sycomix/sumeru/sw/vhdl/timing_analysis_experiments/ram_propogation_test/TECHMAP.png

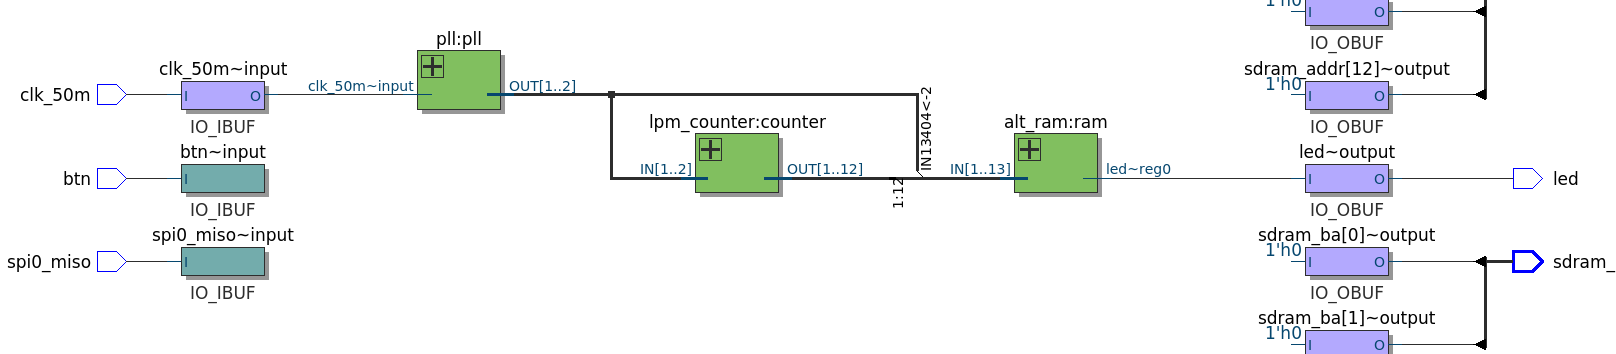
sw/vhdl/timing_analysis_experiments/ram_propogation_test/TECHMAP.png
