sycomix/sumeru/hw/pcb/mark1/mark1.kicad_pcb

## KiCad design hw/pcb/mark1/mark1.kicad_pcb (2019-08-19, an earlier design)

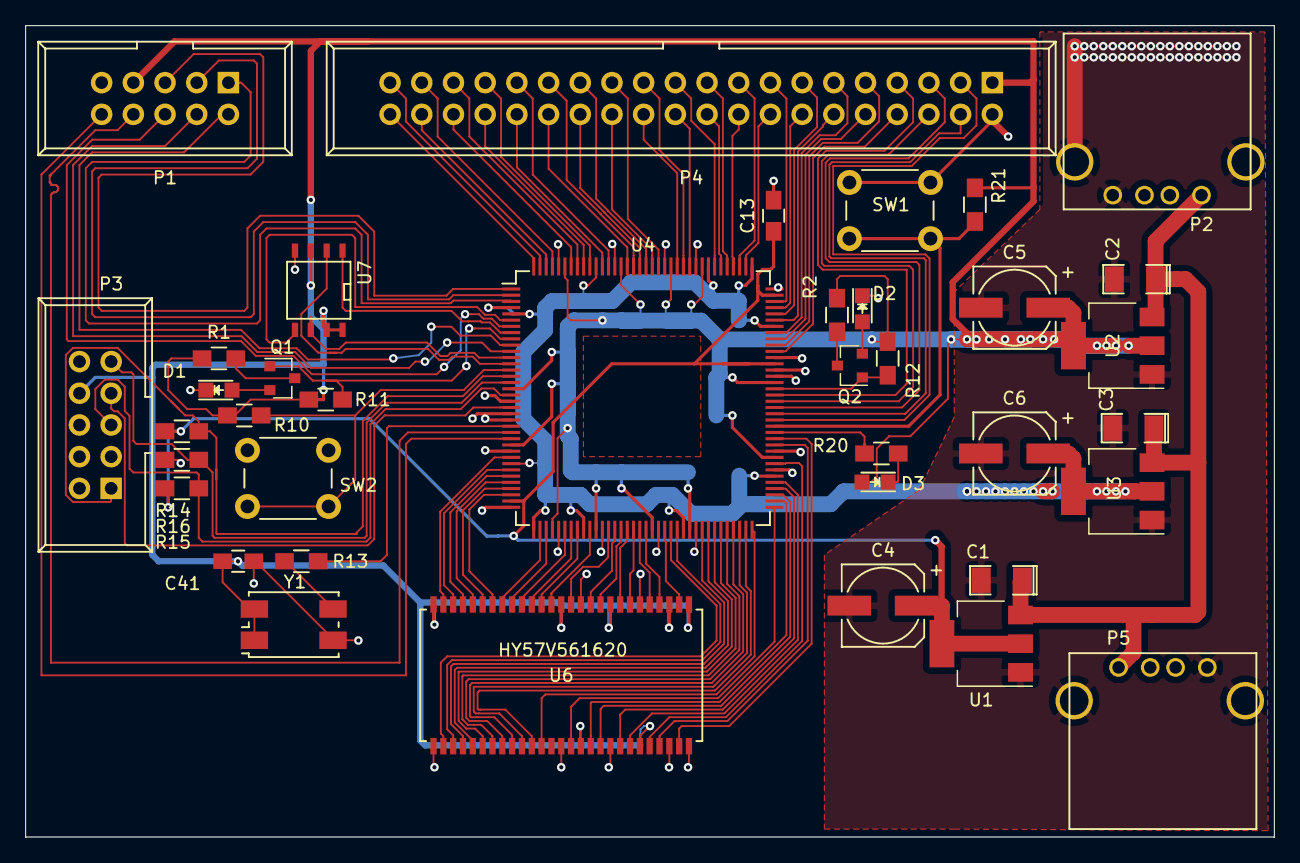
[picture p3: board mark1.kicad_pcb from above]

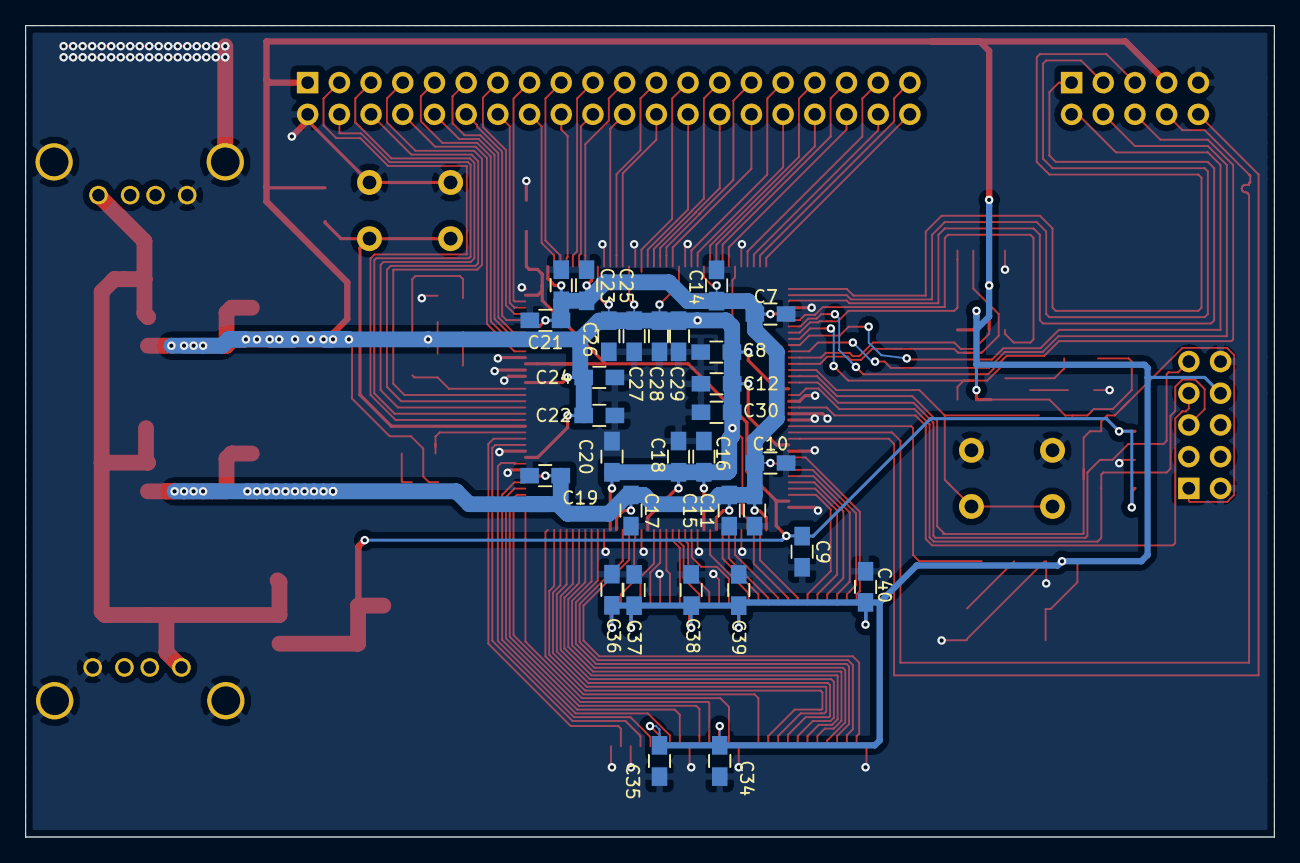
[picture p4: board mark1.kicad_pcb from below]

Board: 2 copper layers, 100.1 x 65.0 mm, 68 parts (30 on the bottom side), 110 nets.

Parts:
C1, C2, C3: 10uF; SMD-1206_Pol
C4, C5, C6: 100uF; c_elec_6.3x7.7
C7, C8, C9, C10, C11, C12, C13, C14, C15, C16, C17, C18, C19, C20, C21, C22, C23, C24, C25, C26, C27, C28, C29, C30, C34, C35, C36, C37, C38, C39, C40, C41: 100nF; C_0805_HandSoldering
D1, D2, D3: LED; LED_0805
P1, P3: CONN_02X05; IDC_Header_Straight_10pins
P2, P5: USB_A
P4: CONN_02X20; IDC_Header_Straight_40pins
Q1, Q2: MMBT3904; SOT-23
R1, R2, R16, R20: 1K; R_0805_HandSoldering
R10, R11, R12, R14, R15: 10K; R_0805_HandSoldering
R13: 33; R_0805_HandSoldering
R21: 1k; R_0805_HandSoldering
SW1, SW2: SW_Push; SW_PUSH_6mm_h4.3mm
U1: AMS1117-2.5; SOT-223
U2: AMS1117-3.3; SOT-223
U3: AMS1117-1.2; SOT-223
U4: EP4CE10E22C8N; TQFP-144_20x20mm_Pitch0.5mm
U6: HY57V561620; WIN_TSOP-54
U7: W25Q32FVSSIQ; SOIC-8-N
Y1: Crystal_GND23; Crystal_SMD_7050_4Pads_R

Connections:
/FPGA Configuration Circuitry/FLASH_MISO: U4.13, U7.2
/FPGA Configuration Circuitry/FLASH_MOSI: U4.6, U7.5
/FPGA Configuration Circuitry/FLASH_SCK: U4.12, U7.6
/FPGA Configuration Circuitry/FLASH_nCE: U4.8, U7.1
/FPGA Configuration Circuitry/F_CLK1: R13.2, U4.23
/FPGA Configuration Circuitry/JTAG_TCK: P3.9, R16.2, U4.16
/FPGA Configuration Circuitry/JTAG_TDI: P3.1, R14.2, U4.15
/FPGA Configuration Circuitry/JTAG_TDO: P3.7, U4.20
/FPGA Configuration Circuitry/JTAG_TMS: P3.5, R15.2, U4.18
/FPGA IO Circuitry/SDRAM1: U4.28, U6.26
/FPGA IO Circuitry/SDRAM2: U4.30, U6.25
/FPGA IO Circuitry/SDRAM3: U4.31, U6.24
/FPGA IO Circuitry/SDRAM4: U4.32, U6.23
/FPGA IO Circuitry/SDRAM5: U4.33, U6.22
/FPGA IO Circuitry/SDRAM6: U4.34, U6.21
/FPGA IO Circuitry/SDRAM7: U4.38, U6.20
/FPGA IO Circuitry/SDRAM8: U4.39, U6.19
/FPGA IO Circuitry/SDRAM9: U4.42, U6.18
/FPGA IO Circuitry/SDRAM10: U4.43, U6.17
/FPGA IO Circuitry/SDRAM11: U4.44, U6.16
/FPGA IO Circuitry/SDRAM12: U4.46, U6.15
/FPGA IO Circuitry/SDRAM13: U4.49, U6.13
/FPGA IO Circuitry/SDRAM14: U4.50, U6.11
/FPGA IO Circuitry/SDRAM15: U4.51, U6.10
/FPGA IO Circuitry/SDRAM16: U4.52, U6.8
/FPGA IO Circuitry/SDRAM17: U4.53, U6.7
/FPGA IO Circuitry/SDRAM18: U4.54, U6.5
/FPGA IO Circuitry/SDRAM19: U4.55, U6.4
/FPGA IO Circuitry/SDRAM20: U4.58, U6.2
/FPGA IO Circuitry/SDRAM21: U4.59, U6.29
/FPGA IO Circuitry/SDRAM22: U4.60, U6.30
/FPGA IO Circuitry/SDRAM23: U4.64, U6.31
/FPGA IO Circuitry/SDRAM24: U4.65, U6.32
/FPGA IO Circuitry/SDRAM25: U4.66, U6.33
/FPGA IO Circuitry/SDRAM26: U4.67, U6.34
/FPGA IO Circuitry/SDRAM27: U4.68, U6.35
/FPGA IO Circuitry/SDRAM28: U4.69, U6.36
/FPGA IO Circuitry/SDRAM29: U4.70, U6.37
/FPGA IO Circuitry/SDRAM30: U4.71, U6.38
/FPGA IO Circuitry/SDRAM31: U4.72, U6.39
/FPGA IO Circuitry/SDRAM32: U4.73, U6.42
/FPGA IO Circuitry/SDRAM33: U4.74, U6.44
/FPGA IO Circuitry/SDRAM34: U4.75, U6.45
/FPGA IO Circuitry/SDRAM35: U4.76, U6.47
/FPGA IO Circuitry/SDRAM36: U4.77, U6.48
/FPGA IO Circuitry/SDRAM37: U4.80, U6.50
/FPGA IO Circuitry/SDRAM38: U4.83, U6.51
/FPGA IO Circuitry/SDRAM39: U4.84, U6.53
F_CLK2: P1.8, U4.24
F_CLK3: P1.10, U4.25
F_CLK4: P4.7, U4.91
F_CLK5: P4.6, U4.90
F_CLK6: P4.5, U4.89
F_CLK7: P4.4, U4.88
GND: C1.2, C2.2, C3.2, C4.2, C5.2, C6.2, C7.2, C8.2, C9.2, C10.2, C11.2, C12.2, C13.2, C14.2, C15.2, C16.2, C17.2, C18.2, C19.2, C20.2, C21.2, C22.2, C23.2, C24.2, C25.2, C26.2, C27.2, C28.2, C29.2, C30.2, C34.2, C35.2, C36.2, C37.2, C38.2, C39.2, C40.2, C41.1, D1.1, D2.1, P1.9, P2.4, P2.5, P3.2, P3.10, P4.2, P5.4, P5.5, R16.1, SW1.1, SW2.1, U1.1, U2.1, U3.1, U4.4, U4.19, U4.21, U4.22, U4.27, U4.36, U4.41, U4.48, U4.57, U4.63, U4.79, U4.82, U4.94, U4.95, U4.97, U4.108, U4.118, U4.123, U4.131, U4.140, U6.6, U6.12, U6.28, U6.41, U6.46, U6.52, U6.54, U7.4, Y1.2
unnamed: D1.2, Q1.2
unnamed: D2.2, Q2.2
unnamed: D3.1, R20.2
unnamed: P1.1, U4.3
unnamed: P1.2, U4.10
unnamed: P1.3, U4.2
unnamed: P1.4, U4.11
unnamed: P1.5, U4.1
unnamed: P1.6, U4.7
unnamed: Q1.1, R11.1, U4.9
unnamed: Q1.3, R1.2
unnamed: Q2.1, R12.1, U4.92
unnamed: Q2.3, R2.2
unnamed: R10.1, SW2.2, U4.14
unnamed: R13.1, Y1.3
unnamed: R21.1, SW1.2, U4.86
PIN85: R20.1, U4.85
PIN87: P4.3, U4.87
PIN98: P4.8, U4.98
PIN99: P4.9, U4.99
PIN100: P4.10, U4.100
PIN101: P4.11, U4.101
PIN103: P4.12, U4.103
PIN104: P4.13, U4.104
PIN105: P4.14, U4.105
PIN106: P4.15, U4.106
PIN110: P4.16, U4.110
PIN111: P4.17, U4.111
PIN112: P4.18, U4.112
PIN113: P4.19, U4.113
PIN114: P4.20, U4.114
PIN115: P4.21, U4.115
PIN119: P4.22, U4.119
PIN120: P4.23, U4.120
PIN121: P4.24, U4.121
PIN124: P4.25, U4.124
PIN125: P4.26, U4.125
PIN126: P4.27, U4.126
PIN127: P4.28, U4.127
PIN128: P4.29, U4.128
PIN129: P4.30, U4.129
PIN132: P4.31, U4.132
PIN133: P4.32, U4.133
PIN135: P4.33, U4.135
PIN136: P4.34, U4.136
PIN137: P4.35, U4.137
PIN138: P4.36, U4.138
PIN141: P4.37, U4.141
PIN142: P4.38, U4.142
PIN143: P4.39, U4.143
PIN144: P4.40, U4.144
VCC: C1.1, C2.1, C3.1, P2.1, P5.1, U1.3, U2.3, U3.3
VCC1p2: C6.1, C7.1, C10.1, C11.1, C14.1, C15.1, C17.1, C19.1, C21.1, C23.1, C25.1, U3.2, U3.4, U4.5, U4.29, U4.37, U4.45, U4.61, U4.78, U4.102, U4.109, U4.116, U4.134
VCC2p5: C4.1, C9.1, C13.1, R14.1, R15.1, U1.2, U1.4, U4.35, U4.96, U4.107
VCC3p3: C5.1, C8.1, C12.1, C16.1, C18.1, C20.1, C22.1, C24.1, C26.1, C27.1, C28.1, C29.1, C30.1, C34.1, C35.1, C36.1, C37.1, C38.1, C39.1, C40.1, C41.2, D3.2, P1.7, P3.8, P4.1, R1.1, R2.1, R10.2, R11.2, R12.2, R21.2, U2.2, U2.4, U4.17, U4.26, U4.40, U4.47, U4.56, U4.62, U4.81, U4.93, U4.117, U4.122, U4.130, U4.139, U6.1, U6.3, U6.9, U6.14, U6.27, U6.43, U6.49, U7.3, U7.7, U7.8, Y1.1, Y1.4
