sycomix/sumeru/sw/kernels/newk/newk.c

#include <machine/constants.h>
#include <machine/csr.h>

#include <stdio.h>
#include <stdlib.h>

#include <machine/uart0.h>


int
main(int argc, char *argv)
{
    char buf[128];
    int c = 0;

    gpio_set_out(0);
    gpio_set_dir(1);
    uart0_start_engine();
    while (1) {
        fgets(buf, 128, stdin);
        fputs(buf, stdin);
    }
    return 0;
}
