sycomix/sumeru/sw/sys-libs/drivers/uart0.c

#include <machine/constants.h>
#include <machine/csr.h>
#include <machine/memctl.h>

#include <stdio.h>
#include <string.h>

#include <machine/uart0.h>

#define MIN(a,b)        (a <= b ? a : b)

consprod_t      g_uart0_tx_cp;
consprod_t      g_uart0_rx_cp;
volatile unsigned int g_uart0_flags = 0;
volatile unsigned int g_uart0_rx_lastpos = 0;
volatile unsigned int g_uart0_rx_timer_enable = 0;

void
uart0_start_engine()
{
    consprod_init(&g_uart0_tx_cp, 
                    (char *)UART0_TX_STREAMBUF_START, 
                    (char *)UART0_TX_STREAMBUF_END);

    consprod_init(&g_uart0_rx_cp, 
                    (char *)UART0_RX_STREAMBUF_START, 
                    (char *)UART0_RX_STREAMBUF_END);

    g_uart0_flags = UART0_ENGINE_ON;
    g_uart0_rx_lastpos = 0;
    uart0_set_rx(UART0_RX_DRVBUF_START | 255);
    timer_set(UART_ENGINE_TIMER_TICKS | 0xf);
}

void
uart0_stop_engine()
{
    g_uart0_flags = 0;
    uart0_set_rx(UART0_RX_DRVBUF_START);
}

int
uart0_blocking_write(const char *buf, unsigned int len)
{
    return consprod_produce(&g_uart0_tx_cp, buf, len, 1);
}

int
uart0_blocking_read(char *buf, unsigned int len)
{
    return consprod_consume(&g_uart0_rx_cp, buf, len, 1);
}


size_t
uart0_blocking_write_multiple(FILE *instance, const char *buf, size_t len)
{
    size_t w = 0;
    size_t count;

    while (w < len) {
        count = MIN(255, len - w);
        uart0_blocking_write(buf + w, count);
        w += count;
    }
    return w;
}

size_t
uart0_blocking_read_multiple(FILE *instance, char *buf, size_t len)
{
    size_t r = 0;
    size_t count;

    while (r < len) {
        count = MIN(255, len - r);
        uart0_blocking_read(buf + r, count);
        r += count;
    }
    return r;
}

struct File_methods uart0_fmethods = { 
    uart0_blocking_write_multiple, 
    uart0_blocking_read_multiple 
    };

struct File uart_fm = { &uart0_fmethods };

FILE* const stdin = &uart_fm;
FILE* const stdout = &uart_fm;
FILE* const stderr = &uart_fm;
