sycomix/sumeru/sw/vhdl/libsrc/rom_2048x16.vhd

LIBRARY ieee;
USE ieee.std_logic_1164.all;

LIBRARY altera_mf;
USE altera_mf.altera_mf_components.all;

ENTITY rom_2048x16 IS
        GENERIC
        (
                AWIDTH          : INTEGER := 11;
                DWIDTH          : INTEGER := 16;
                DATA_FILE       : STRING
        );
	PORT
	(
		address		: IN STD_LOGIC_VECTOR ((AWIDTH - 1) DOWNTO 0);
		clock		: IN STD_LOGIC  := '1';
		q		: OUT STD_LOGIC_VECTOR ((DWIDTH - 1) DOWNTO 0)
	);
END rom_2048x16;


ARCHITECTURE SYN OF rom_2048x16 IS

	SIGNAL sub_wire0	: STD_LOGIC_VECTOR (15 DOWNTO 0);

BEGIN
	q    <= sub_wire0(15 DOWNTO 0);

	altsyncram_component : altsyncram
	GENERIC MAP (
		address_aclr_a => "NONE",
		clock_enable_input_a => "BYPASS",
		clock_enable_output_a => "BYPASS",
		init_file => DATA_FILE,
		intended_device_family => "Cyclone IV E",
		lpm_hint => "ENABLE_RUNTIME_MOD=NO",
		lpm_type => "altsyncram",
		numwords_a => 2048,
		operation_mode => "ROM",
		outdata_aclr_a => "NONE",
		outdata_reg_a => "UNREGISTERED",
		ram_block_type => "M9K",
		widthad_a => AWIDTH,
		width_a => DWIDTH,
		width_byteena_a => 1
	)
	PORT MAP (
		address_a => address,
		clock0 => clock,
		q_a => sub_wire0
	);

END SYN;
