sycomix/sumeru/cpu/simulation/sim_sdram_mt48lc16m16a2.vhd

-- ******** TODO: Implement/Fix DQM logic to support 2 bytes instead of 1
--
LIBRARY IEEE;
    USE IEEE.STD_LOGIC_1164.ALL;
    USE IEEE.STD_LOGIC_UNSIGNED.ALL;
    USE IEEE.STD_LOGIC_ARITH.ALL;

ENTITY sim_sdram_mt48lc16m16a2 IS
    GENERIC (
        -- Timing Parameters for -75 (PC133) and CL = 3
        tAC       : TIME    :=  6 ns;
        tHZ       : TIME    :=  6 ns;
        tOH       : TIME    :=  3 ns;
        tMRD      : INTEGER :=  2;          -- 2 Clk Cycles
        tRAS      : TIME    := 44.0 ns;
        tRC       : TIME    := 66.0 ns;
        tRCD      : TIME    := 20.0 ns;
        tRFC      : TIME    := 66.0 ns;
        tRP       : TIME    := 20.0 ns;
        tRRD      : TIME    := 15.0 ns;
        tWRa      : TIME    :=  7.5 ns;     -- Auto precharge
        tWRm      : TIME    := 15.0 ns;     -- Manual Precharge

        tAH       : TIME    :=  0.8 ns;
        tAS       : TIME    :=  1.5 ns;
        tCH       : TIME    :=  2.5 ns;
        tCL       : TIME    :=  2.5 ns;
        tCK       : TIME    :=  7.5 ns;
        tDH       : TIME    :=  0.8 ns;
        tDS       : TIME    :=  1.5 ns;
        tCKH      : TIME    :=  0.8 ns;
        tCKS      : TIME    :=  1.5 ns;
        tCMH      : TIME    :=  0.8 ns;
        tCMS      : TIME    :=  1.5 ns;

        addr_bits : INTEGER := 13;
        data_bits : INTEGER := 16;
        col_bits  : INTEGER := 9
    );
    PORT (
        Dq    : INOUT STD_LOGIC_VECTOR (data_bits - 1 DOWNTO 0) := (OTHERS => 'Z');
        Addr  : IN    STD_LOGIC_VECTOR (addr_bits - 1 DOWNTO 0) := (OTHERS => '0');
        Ba    : IN    STD_LOGIC_VECTOR (1 DOWNTO 0) := "00";
        Clk   : IN    STD_LOGIC := '0';
        Cke   : IN    STD_LOGIC := '1';
        Cs_n  : IN    STD_LOGIC := '1';
        Ras_n : IN    STD_LOGIC := '1';
        Cas_n : IN    STD_LOGIC := '1';
        We_n  : IN    STD_LOGIC := '1';
        Dqm   : IN    STD_LOGIC_VECTOR(1 downto 0) := "00"
    );
END sim_sdram_mt48lc16m16a2;

ARCHITECTURE behave OF sim_sdram_mt48lc16m16a2 IS
    TYPE   State       IS (BST, NOP, PRECH, READ, WRITE);
    TYPE   Array4xI    IS ARRAY (3 DOWNTO 0) OF INTEGER;
    TYPE   Array4xT    IS ARRAY (3 DOWNTO 0) OF TIME;
    TYPE   Array4xB    IS ARRAY (3 DOWNTO 0) OF STD_LOGIC;
    TYPE   Array4x2BV  IS ARRAY (3 DOWNTO 0) OF STD_LOGIC_VECTOR (1 DOWNTO 0);
    TYPE   Array4xCBV  IS ARRAY (4 DOWNTO 0) OF STD_LOGIC_VECTOR (Col_bits - 1 DOWNTO 0);
    TYPE   Array_state IS ARRAY (4 DOWNTO 0) OF State;
    SIGNAL Mode_reg : STD_LOGIC_VECTOR (addr_bits - 1 DOWNTO 0) := (OTHERS => '0');
    SIGNAL Active_enable, Aref_enable, Burst_term : STD_LOGIC := '0';
    SIGNAL Mode_reg_enable, Prech_enable, Read_enable, Write_enable : STD_LOGIC := '0';
    SIGNAL Burst_length_1, Burst_length_2, Burst_length_4, Burst_length_8 : STD_LOGIC := '0';
    SIGNAL Cas_latency_2, Cas_latency_3 : STD_LOGIC := '0';
    SIGNAL Cs_in, Ras_in, Cas_in, We_in : STD_LOGIC := '0';
    SIGNAL Write_burst_mode : STD_LOGIC := '0';
    SIGNAL Sys_clk, CkeZ : STD_LOGIC := '0';

    type commands is (INH, NOP, ACT, RD, WR, BT, PRE, REF, MD, XX);
    signal command : commands;
    signal cmdbits : std_logic_vector(3 downto 0);


BEGIN
    cmdbits <= Cs_n & Ras_n & Cas_n & We_n;
    command <=
      INH when cmdbits = "1111" else
      NOP when cmdbits = "0111" else
      ACT when cmdbits = "0011" else
      RD when cmdbits = "0101" else
      WR when cmdbits = "0100" else
      BT when cmdbits = "0110" else
      PRE when cmdbits = "0010" else
      REF when cmdbits = "0001" else
      MD when cmdbits = "0000" else
      XX;

    -- Strip the strength
    Cs_in  <= To_X01 (Cs_n);
    Ras_in <= To_X01 (Ras_n);
    Cas_in <= To_X01 (Cas_n);
    We_in  <= To_X01 (We_n);
    
    -- Commands Decode
    Active_enable   <= NOT(Cs_in) AND NOT(Ras_in) AND     Cas_in  AND     We_in;
    Aref_enable     <= NOT(Cs_in) AND NOT(Ras_in) AND NOT(Cas_in) AND     We_in;
    Burst_term      <= NOT(Cs_in) AND     Ras_in  AND     Cas_in  AND NOT(We_in);
    Mode_reg_enable <= NOT(Cs_in) AND NOT(Ras_in) AND NOT(Cas_in) AND NOT(We_in);
    Prech_enable    <= NOT(Cs_in) AND NOT(Ras_in) AND     Cas_in  AND NOT(We_in);
    Read_enable     <= NOT(Cs_in) AND     Ras_in  AND NOT(Cas_in) AND     We_in;
    Write_enable    <= NOT(Cs_in) AND     Ras_in  AND NOT(Cas_in) AND NOT(We_in);

    -- Burst Length Decode
    Burst_length_1  <= NOT(Mode_reg(2)) AND NOT(Mode_reg(1)) AND NOT(Mode_reg(0));
    Burst_length_2  <= NOT(Mode_reg(2)) AND NOT(Mode_reg(1)) AND     Mode_reg(0);
    Burst_length_4  <= NOT(Mode_reg(2)) AND     Mode_reg(1)  AND NOT(Mode_reg(0));
    Burst_length_8  <= NOT(Mode_reg(2)) AND     Mode_reg(1)  AND     Mode_reg(0);

    -- CAS Latency Decode
    Cas_latency_2   <= NOT(Mode_reg(6)) AND     Mode_reg(5)  AND NOT(Mode_reg(4));
    Cas_latency_3   <= NOT(Mode_reg(6)) AND     Mode_reg(5)  AND     Mode_reg(4);

    -- Write Burst Mode
    Write_burst_mode <= Mode_reg(9);

    -- System Clock
    int_clk : PROCESS (Clk)
    BEGIN
        IF Clk'LAST_VALUE = '0' AND Clk = '1' THEN
            CkeZ <= Cke;
        END IF;
        Sys_clk <= CkeZ AND Clk;
    END PROCESS;

    state_register : PROCESS
        TYPE ram_type IS ARRAY (2**col_bits - 1 DOWNTO 0) OF STD_LOGIC_VECTOR ((data_bits / 2) - 1 DOWNTO 0);
        TYPE ram_pntr IS ACCESS ram_type;
        TYPE ram_stor IS ARRAY (2**addr_bits - 1 DOWNTO 0) OF ram_pntr;
        VARIABLE Bank0_a : ram_stor;
        VARIABLE Bank0_b : ram_stor;
        VARIABLE Bank1_a : ram_stor;
        VARIABLE Bank1_b : ram_stor;
        VARIABLE Bank2_a : ram_stor;
        VARIABLE Bank2_b : ram_stor;
        VARIABLE Bank3_a : ram_stor;
        VARIABLE Bank3_b : ram_stor;
        VARIABLE Row_index, Col_index : INTEGER := 0;
        VARIABLE Dq_temp_a : STD_LOGIC_VECTOR ((data_bits / 2) - 1 DOWNTO 0) := (OTHERS => '0');
        VARIABLE Dq_temp_b : STD_LOGIC_VECTOR ((data_bits / 2) - 1 DOWNTO 0) := (OTHERS => '0');

        VARIABLE Col_addr : Array4xCBV;
        VARIABLE Bank_addr : Array4x2BV;
        VARIABLE Dqm_reg0, Dqm_reg1 : STD_LOGIC_VECTOR(1 downto 0) := "11";

        VARIABLE Bank, Prev_bank : STD_LOGIC_VECTOR (1 DOWNTO 0) := "00";
        VARIABLE B0_row_addr, B1_row_addr, B2_row_addr, B3_row_addr : STD_LOGIC_VECTOR (addr_bits - 1 DOWNTO 0) := (OTHERS => '0');
        VARIABLE Col_brst : STD_LOGIC_VECTOR (col_bits - 1 DOWNTO 0) := (OTHERS => '0');
        VARIABLE Row : STD_LOGIC_VECTOR (addr_bits - 1 DOWNTO 0) := (OTHERS => '0');
        VARIABLE Col : STD_LOGIC_VECTOR (col_bits - 1 DOWNTO 0) := (OTHERS => '0');
        VARIABLE Burst_counter : INTEGER := 0;

        VARIABLE Command : Array_state;
        VARIABLE Bank_precharge : Array4x2BV;
        VARIABLE A10_precharge : Array4xB := ('0' & '0' & '0' & '0');
        VARIABLE Auto_precharge : Array4xB := ('0' & '0' & '0' & '0');
        VARIABLE Read_precharge : Array4xB := ('0' & '0' & '0' & '0');
        VARIABLE Write_precharge : Array4xB := ('0' & '0' & '0' & '0');
        VARIABLE RW_interrupt_read : Array4xB := ('0' & '0' & '0' & '0');
        VARIABLE RW_interrupt_write : Array4xB := ('0' & '0' & '0' & '0');
        VARIABLE RW_interrupt_bank : STD_LOGIC_VECTOR (1 DOWNTO 0) := "00";
        VARIABLE RW_interrupt_counter : Array4xI := (0 & 0 & 0 & 0);
        VARIABLE Count_precharge : Array4xI := (0 & 0 & 0 & 0);

        VARIABLE Data_in_enable, Data_out_enable : STD_LOGIC := '0';
        VARIABLE Pc_b0, Pc_b1, Pc_b2, Pc_b3 : STD_LOGIC := '0';
        VARIABLE Act_b0, Act_b1, Act_b2, Act_b3 : STD_LOGIC := '1';

        -- Timing Check
        VARIABLE MRD_chk : INTEGER := 0;
        VARIABLE RFC_chk : TIME := 0 ns;
        VARIABLE RRD_chk : TIME := 0 ns;
        VARIABLE WR_chkm : Array4xT := (0 ns & 0 ns & 0 ns & 0 ns);
        VARIABLE RAS_chk0, RAS_chk1, RAS_chk2, RAS_chk3 : TIME := 0 ns;
        VARIABLE RC_chk0, RC_chk1, RC_chk2, RC_chk3 : TIME := 0 ns;
        VARIABLE RCD_chk0, RCD_chk1, RCD_chk2, RCD_chk3 : TIME := 0 ns;
        VARIABLE RP_chk0, RP_chk1, RP_chk2, RP_chk3 : TIME := 0 ns;

        -- Initialize empty rows
        PROCEDURE Init_mem_a (Bank : STD_LOGIC_VECTOR (1 DOWNTO 0); Row_index : INTEGER) IS
            VARIABLE i, j : INTEGER := 0;
        BEGIN
            IF Bank = "00" THEN
                IF Bank0_a (Row_index) = NULL THEN                      -- Check to see if row empty
                    Bank0_a (Row_index) := NEW ram_type;                  -- Open new row for access
                    FOR i IN (2**col_bits - 1) DOWNTO 0 LOOP            -- Filled row with zeros
                        FOR j IN ((data_bits / 2) - 1) DOWNTO 0 LOOP
                            Bank0_a (Row_index) (i) (j) := '0';
                        END LOOP;
                    END LOOP;
                END IF;
            ELSIF Bank = "01" THEN
                IF Bank1_a (Row_index) = NULL THEN
                    Bank1_a (Row_index) := NEW ram_type;
                    FOR i IN (2**col_bits - 1) DOWNTO 0 LOOP
                        FOR j IN ((data_bits / 2) - 1) DOWNTO 0 LOOP
                            Bank1_a (Row_index) (i) (j) := '0';
                        END LOOP;
                    END LOOP;
                END IF;
            ELSIF Bank = "10" THEN
                IF Bank2_a (Row_index) = NULL THEN
                    Bank2_a (Row_index) := NEW ram_type;
                    FOR i IN (2**col_bits - 1) DOWNTO 0 LOOP
                        FOR j IN ((data_bits / 2) - 1) DOWNTO 0 LOOP
                            Bank2_a (Row_index) (i) (j) := '0';
                        END LOOP;
                    END LOOP;
                END IF;
            ELSIF Bank = "11" THEN
                IF Bank3_a (Row_index) = NULL THEN
                    Bank3_a (Row_index) := NEW ram_type;
                    FOR i IN (2**col_bits - 1) DOWNTO 0 LOOP
                        FOR j IN ((data_bits / 2) - 1) DOWNTO 0 LOOP
                            Bank3_a (Row_index) (i) (j) := '0';
                        END LOOP;
                    END LOOP;
                END IF;
            END IF;
        END;

        PROCEDURE Init_mem_b (Bank : STD_LOGIC_VECTOR (1 DOWNTO 0); Row_index : INTEGER) IS
            VARIABLE i, j : INTEGER := 0;
        BEGIN
            IF Bank = "00" THEN
                IF Bank0_b (Row_index) = NULL THEN                      -- Check to see if row empty
                    Bank0_b (Row_index) := NEW ram_type;                  -- Open new row for access
                    FOR i IN (2**col_bits - 1) DOWNTO 0 LOOP            -- Filled row with zeros
                        FOR j IN ((data_bits / 2) - 1) DOWNTO 0 LOOP
                            Bank0_b (Row_index) (i) (j) := '0';
                        END LOOP;
                    END LOOP;
                END IF;
            ELSIF Bank = "01" THEN
                IF Bank1_b (Row_index) = NULL THEN
                    Bank1_b (Row_index) := NEW ram_type;
                    FOR i IN (2**col_bits - 1) DOWNTO 0 LOOP
                        FOR j IN ((data_bits / 2) - 1) DOWNTO 0 LOOP
                            Bank1_b (Row_index) (i) (j) := '0';
                        END LOOP;
                    END LOOP;
                END IF;
            ELSIF Bank = "10" THEN
                IF Bank2_b (Row_index) = NULL THEN
                    Bank2_b (Row_index) := NEW ram_type;
                    FOR i IN (2**col_bits - 1) DOWNTO 0 LOOP
                        FOR j IN ((data_bits / 2) - 1) DOWNTO 0 LOOP
                            Bank2_b (Row_index) (i) (j) := '0';
                        END LOOP;
                    END LOOP;
                END IF;
            ELSIF Bank = "11" THEN
                IF Bank3_b (Row_index) = NULL THEN
                    Bank3_b (Row_index) := NEW ram_type;
                    FOR i IN (2**col_bits - 1) DOWNTO 0 LOOP
                        FOR j IN ((data_bits / 2) - 1) DOWNTO 0 LOOP
                            Bank3_b (Row_index) (i) (j) := '0';
                        END LOOP;
                    END LOOP;
                END IF;
            END IF;
        END;

        -- Burst Counter
        PROCEDURE Burst_decode IS
            VARIABLE Col_int : INTEGER := 0;
            VARIABLE Col_vec, Col_temp : STD_LOGIC_VECTOR (col_bits - 1 DOWNTO 0) := (OTHERS => '0');
        BEGIN
            -- Advance Burst Counter
            Burst_counter := Burst_counter + 1;

            -- Burst Type
            IF Mode_reg (3) = '0' THEN
                Col_int := conv_integer(Col) + 1;
                Col_temp := CONV_STD_LOGIC_VECTOR(Col_int, col_bits);
            ELSIF Mode_reg (3) = '1' THEN
                Col_vec := CONV_STD_LOGIC_VECTOR(Burst_counter, col_bits);
                Col_temp (2) := Col_vec (2) XOR Col_brst (2);
                Col_temp (1) := Col_vec (1) XOR Col_brst (1);
                Col_temp (0) := Col_vec (0) XOR Col_brst (0);
            END IF;

            -- Burst Length
            IF Burst_length_2 = '1' THEN
                Col (0) := Col_temp (0);
            ELSIF Burst_length_4 = '1' THEN
                Col (1 DOWNTO 0) := Col_temp (1 DOWNTO 0);
            ELSIF Burst_length_8 = '1' THEN
                Col (2 DOWNTO 0) := Col_temp (2 DOWNTO 0);
            ELSE
                Col := Col_temp;
            END IF;

            -- Burst Read Single Write
            IF Write_burst_mode = '1' AND Data_in_enable = '1' THEN
                Data_in_enable := '0';
            END IF;

            -- Data counter
            IF Burst_length_1 = '1' THEN
                IF Burst_counter >= 1 THEN
                    IF Data_in_enable = '1' THEN
                        Data_in_enable := '0';
                    ELSIF Data_out_enable = '1' THEN
                        Data_out_enable := '0';
                    END IF;
                END IF;
            ELSIF Burst_length_2 = '1' THEN
                IF Burst_counter >= 2 THEN
                    IF Data_in_enable = '1' THEN
                        Data_in_enable := '0';
                    ELSIF Data_out_enable = '1' THEN
                        Data_out_enable := '0';
                    END IF;
                END IF;
            ELSIF Burst_length_4 = '1' THEN
                IF Burst_counter >= 4 THEN
                    IF Data_in_enable = '1' THEN
                        Data_in_enable := '0';
                    ELSIF Data_out_enable = '1' THEN
                        Data_out_enable := '0';
                    END IF;
                END IF;
            ELSIF Burst_length_8 = '1' THEN
                IF Burst_counter >= 8 THEN
                    IF Data_in_enable = '1' THEN
                        Data_in_enable := '0';
                    ELSIF Data_out_enable = '1' THEN
                        Data_out_enable := '0';
                    END IF;
                END IF;
            END IF;
        END;

    BEGIN
        WAIT ON Sys_clk;
        IF Sys_clk'event AND Sys_clk = '1' THEN
            -- Internal Pipeline
            Command(0) := Command(1);
            Command(1) := Command(2);
            Command(2) := Command(3);
            Command(3) := NOP;

            Col_addr(0) := Col_addr(1);
            Col_addr(1) := Col_addr(2);
            Col_addr(2) := Col_addr(3);
            Col_addr(3) := (OTHERS => '0');
            
            Bank_addr(0) := Bank_addr(1);
            Bank_addr(1) := Bank_addr(2);
            Bank_addr(2) := Bank_addr(3);
            Bank_addr(3) := "00";

            Bank_precharge(0) := Bank_precharge(1);
            Bank_precharge(1) := Bank_precharge(2);
            Bank_precharge(2) := Bank_precharge(3);
            Bank_precharge(3) := "00";

            A10_precharge(0) := A10_precharge(1);
            A10_precharge(1) := A10_precharge(2);
            A10_precharge(2) := A10_precharge(3);
            A10_precharge(3) := '0';
            
            -- Dqm pipeline for Read
            Dqm_reg0 := Dqm_reg1;
            Dqm_reg1 := Dqm;

            -- Read or Write with Auto Precharge Counter
            IF Auto_precharge (0) = '1' THEN
                Count_precharge (0) := Count_precharge (0) + 1;
            END IF;
            IF Auto_precharge (1) = '1' THEN
                Count_precharge (1) := Count_precharge (1) + 1;
            END IF;
            IF Auto_precharge (2) = '1' THEN
                Count_precharge (2) := Count_precharge (2) + 1;
            END IF;
            IF Auto_precharge (3) = '1' THEN
                Count_precharge (3) := Count_precharge (3) + 1;
            END IF;

            -- Read or Write Interrupt Counter
            IF RW_interrupt_write (0) = '1' THEN
               RW_interrupt_counter  (0) := RW_interrupt_counter (0) + 1;
            END IF;
            IF RW_interrupt_write (1) = '1' THEN
                RW_interrupt_counter (1) := RW_interrupt_counter (1) + 1;
            END IF;
            IF RW_interrupt_write (2) = '1' THEN
                RW_interrupt_counter (2) := RW_interrupt_counter (2) + 1;
            END IF;
            IF RW_interrupt_write (3) = '1' THEN
                RW_interrupt_counter (3) := RW_interrupt_counter (3) + 1;
            END IF;

            -- tMRD Counter
            MRD_chk := MRD_chk + 1;

            -- Auto Refresh
            IF Aref_enable = '1' THEN
                -- Auto Refresh to Auto Refresh
                ASSERT (NOW - RFC_chk >= tRFC)
                    REPORT "tRFC violation during Auto Refresh"
                    SEVERITY WARNING;

                -- Precharge to Auto Refresh
                ASSERT ((NOW - RP_chk0 >= tRP) OR (NOW - RP_chk1 >= tRP) OR 
                        (NOW - RP_chk2 >= tRP) OR (NOW - RP_chk3 >= tRP))
                    REPORT "tRP violation during Auto Refresh"
                    SEVERITY WARNING;

                -- Precharge to Auto Refresh
                ASSERT (Pc_b0 ='1' AND Pc_b1 = '1' AND Pc_b2 ='1' AND Pc_b3 = '1')
                    REPORT "All banks must be Precharge before Auto Refresh"
                    SEVERITY WARNING;

                -- Load Mode Register to Auto Refresh
                ASSERT (MRD_chk >= tMRD)
                    REPORT "tMRD violation during Auto Refresh"
                    SEVERITY WARNING;

                -- Record current tRFC time
                RFC_chk := NOW;
            END IF;

            -- Load Mode Register
            IF Mode_reg_enable = '1' THEN
                -- Register Mode
                Mode_reg <= Addr;

                -- Precharge to Load Mode Register
                ASSERT (Pc_b0 ='1' AND Pc_b1 = '1' AND Pc_b2 ='1' AND Pc_b3 = '1')
                    REPORT "All banks must be Precharge before Load Mode Register"
                    SEVERITY WARNING;

                -- Precharge to Load Mode Register
                ASSERT ((NOW - RP_chk0 >= tRP) OR (NOW - RP_chk1 >= tRP) OR 
                        (NOW - RP_chk2 >= tRP) OR (NOW - RP_chk3 >= tRP))
                    REPORT "tRP violation during Load Mode Register"
                    SEVERITY WARNING;

                -- Auto Refresh to Load Mode Register
                ASSERT (NOW - RFC_chk >= tRFC)
                    REPORT "tRFC violation during Load Mode Register"
                    SEVERITY WARNING;

                -- Load Mode Register to Load Mode Register
                ASSERT (MRD_chk >= tMRD)
                    REPORT "tMRD violation during Load Mode Register"
                    SEVERITY WARNING;

                -- Record current tMRD time
                MRD_chk := 0;
            END IF;

            -- Active Block (Latch Bank and Row Address)
            IF Active_enable = '1' THEN
                -- Activate an OPEN bank can corrupt data
                ASSERT ((Ba = "00" AND Act_b0 = '0') OR (Ba = "01" AND Act_b1 = '0') OR
                        (Ba = "10" AND Act_b2 = '0') OR (Ba = "11" AND Act_b3 = '0'))
                    REPORT "Bank is already activated - data can be corrupted"
                    SEVERITY WARNING;

                -- Activate Bank 0
                IF Ba = "00" AND Pc_b0 = '1' THEN
                    -- Activate to Activate (same bank)
                    ASSERT (NOW - RC_chk0 >= tRC)
                        REPORT "tRC violation during Activate Bank 0"
                        SEVERITY WARNING;

                    -- Precharge to Activate
                    ASSERT (NOW - RP_chk0 >= tRP)
                        REPORT "tRP violation during Activate Bank 0"
                        SEVERITY WARNING;

                    -- Record variables for checking violation
                    Act_b0 := '1';
                    Pc_b0 := '0';
                    B0_row_addr := Addr;
                    RAS_chk0 := NOW;
                    RC_chk0 := NOW;
                    RCD_chk0 := NOW;
                END IF;

                -- Activate Bank 1
                IF Ba = "01" AND Pc_b1 = '1' THEN
                    -- Activate to Activate (same bank)
                    ASSERT (NOW - RC_chk1 >= tRC)
                        REPORT "tRC violation during Activate Bank 1"
                        SEVERITY WARNING;

                    -- Precharge to Activate
                    ASSERT (NOW - RP_chk1 >= tRP)
                        REPORT "tRP violation during Activate Bank 1"
                        SEVERITY WARNING;

                    -- Record variables for checking violation
                    Act_b1 := '1';
                    Pc_b1 := '0';
                    B1_row_addr := Addr;
                    RAS_chk1 := NOW;
                    RC_chk1 := NOW;
                    RCD_chk1 := NOW;
                END IF;

                -- Activate Bank 2
                IF Ba = "10" AND Pc_b2 = '1' THEN
                    -- Activate to Activate (same bank)
                    ASSERT (NOW - RC_chk2 >= tRC)
                        REPORT "tRC violation during Activate Bank 2"
                        SEVERITY WARNING;

                    -- Precharge to Activate
                    ASSERT (NOW - RP_chk2 >= tRP)
                        REPORT "tRP violation during Activate Bank 2"
                        SEVERITY WARNING;

                    -- Record variables for checking violation
                    Act_b2 := '1';
                    Pc_b2 := '0';
                    B2_row_addr := Addr;
                    RAS_chk2 := NOW;
                    RC_chk2 := NOW;
                    RCD_chk2 := NOW;
                END IF;

                -- Activate Bank 3
                IF Ba = "11" AND Pc_b3 = '1' THEN
                    -- Activate to Activate (same bank)
                    ASSERT (NOW - RC_chk3 >= tRC)
                        REPORT "tRC violation during Activate Bank 3"
                        SEVERITY WARNING;

                    -- Precharge to Activate
                    ASSERT (NOW - RP_chk3 >= tRP)
                        REPORT "tRP violation during Activate Bank 3"
                        SEVERITY WARNING;

                    -- Record variables for checking violation
                    Act_b3 := '1';
                    Pc_b3 := '0';
                    B3_row_addr := Addr;
                    RAS_chk3 := NOW;
                    RC_chk3 := NOW;
                    RCD_chk3 := NOW;
                END IF;

                -- Activate to Activate (different bank)
                IF (Prev_bank /= Ba) THEN
                    ASSERT (NOW - RRD_chk >= tRRD)
                        REPORT "tRRD violation during Activate"
                        SEVERITY WARNING;
                END IF;

                -- Auto Refresh to Activate
                ASSERT (NOW - RFC_chk >= tRFC)
                    REPORT "tRFC violation during Activate"
                    SEVERITY WARNING;

                -- Load Mode Register to Activate
                ASSERT (MRD_chk >= tMRD)
                    REPORT "tMRD violation during Activate"
                    SEVERITY WARNING;

                -- Record variable for checking violation
                RRD_chk := NOW;
                Prev_Bank := Ba;
            END IF;

            -- Precharge Block
            IF Prech_enable = '1' THEN
                -- Load Mode Register to Precharge
                ASSERT (MRD_chk >= tMRD)
                    REPORT "tMRD violation during Precharge"
                    SEVERITY WARNING;

                -- Precharge Bank 0
                IF ((Addr (10) = '1' OR (Addr (10) = '0' AND Ba = "00")) AND Act_b0 = '1') THEN
                    Act_b0 := '0';
                    Pc_b0 := '1';
                    RP_chk0 := NOW;

                    -- Activate to Precharge
                    ASSERT (NOW - RAS_chk0 >= tRAS)
                        REPORT "tRAS violation during Precharge"
                        SEVERITY WARNING;

                    -- tWR violation check for Write
                    ASSERT (NOW - WR_chkm(0) >= tWRm)
                        REPORT "tWR violation during Precharge"
                        SEVERITY WARNING;
                END IF;

                -- Precharge Bank 1
                IF ((Addr (10) = '1' OR (Addr (10) = '0' AND Ba = "01")) AND Act_b1 = '1') THEN
                    Act_b1 := '0';
                    Pc_b1 := '1';
                    RP_chk1 := NOW;

                    -- Activate to Precharge
                    ASSERT (NOW - RAS_chk1 >= tRAS)
                        REPORT "tRAS violation during Precharge"
                        SEVERITY WARNING;

                    -- tWR violation check for Write
                    ASSERT (NOW - WR_chkm(1) >= tWRm)
                        REPORT "tWR violation during Precharge"
                        SEVERITY WARNING;
                END IF;

                -- Precharge Bank 2
                IF ((Addr (10) = '1' OR (Addr (10) = '0' AND Ba = "10")) AND Act_b2 = '1') THEN
                    Act_b2 := '0';
                    Pc_b2 := '1';
                    RP_chk2 := NOW;

                    -- Activate to Precharge
                    ASSERT (NOW - RAS_chk2 >= tRAS)
                        REPORT "tRAS violation during Precharge"
                        SEVERITY WARNING;

                    -- tWR violation check for Write
                    ASSERT (NOW - WR_chkm(2) >= tWRm)
                        REPORT "tWR violation during Precharge"
                        SEVERITY WARNING;
                END IF;

                -- Precharge Bank 3
                IF ((Addr (10) = '1' OR (Addr (10) = '0' AND Ba = "11")) AND Act_b3 = '1') THEN
                    Act_b3 := '0';
                    Pc_b3 := '1';
                    RP_chk3 := NOW;

                    -- Activate to Precharge
                    ASSERT (NOW - RAS_chk3 >= tRAS)
                        REPORT "tRAS violation during Precharge"
                        SEVERITY WARNING;

                    -- tWR violation check for Write
                    ASSERT (NOW - WR_chkm(3) >= tWRm)
                        REPORT "tWR violation during Precharge"
                        SEVERITY WARNING;
                END IF;

                -- Terminate a Write Immediately (if same bank or all banks)
                IF (Data_in_enable = '1' AND (Bank = Ba OR Addr(10) = '1')) THEN
                    Data_in_enable := '0';
                END IF;

                -- Precharge Command Pipeline for READ
                IF CAS_latency_3 = '1' THEN
                    Command(2) := PRECH;
                    Bank_precharge(2) := Ba;
                    A10_precharge(2) := Addr(10);
                ELSIF CAS_latency_2 = '1' THEN
                    Command(1) := PRECH;
                    Bank_precharge(1) := Ba;
                    A10_precharge(1) := Addr(10);
                END IF;
            END IF;

            -- Burst Terminate
            IF Burst_term = '1' THEN
                -- Terminate a Write immediately
                IF Data_in_enable = '1' THEN
                    Data_in_enable := '0';
                END IF;

                -- Terminate a Read depend on CAS Latency
                IF CAS_latency_3 = '1' THEN
                    Command(2) := BST;
                ELSIF CAS_latency_2 = '1' THEN
                    Command(1) := BST;
                END IF;
            END IF;

            -- Read Command
            IF Read_enable = '1' THEN
                -- Activate to Read
                ASSERT ((Ba="00" AND Act_b0='1') OR (Ba="01" AND Act_b1='1') OR
                        (Ba="10" AND Act_b2='1') OR (Ba="11" AND Act_b3='1'))
                    REPORT "Bank is not Activated for Read"
                    SEVERITY WARNING;

                -- Activate to Read
                ASSERT ((Ba = "00" AND NOW - RCD_chk0 >= tRCD) OR
                        (Ba = "01" AND NOW - RCD_chk1 >= tRCD) OR
                        (Ba = "10" AND NOW - RCD_chk2 >= tRCD) OR
                        (Ba = "11" AND NOW - RCD_chk3 >= tRCD))
                    REPORT "tRCD violation during Read"
                    SEVERITY WARNING;

                -- CAS Latency Pipeline
                IF Cas_latency_3 = '1' THEN
                    Command(2) := READ;
                    Col_addr (2) := Addr(8 DOWNTO 0);
                    Bank_addr (2) := Ba;
                ELSIF Cas_latency_2 = '1' THEN
                    Command(1) := READ;
                    Col_addr (1) := Addr(8 DOWNTO 0);
                    Bank_addr (1) := Ba;
                END IF;

                -- Read Terminate Write Immediately
                IF Data_in_enable = '1' THEN
                    Data_in_enable := '0';
                    -- Interrupt a Write with Auto Precharge
                    IF Auto_precharge(CONV_INTEGER(RW_Interrupt_Bank)) = '1' AND Write_precharge(CONV_INTEGER(RW_Interrupt_Bank)) = '1' THEN
                        RW_interrupt_write(CONV_INTEGER(RW_Interrupt_Bank)) := '1';
                        RW_interrupt_counter (CONV_INTEGER(RW_Interrupt_Bank)) := 0;
                        ASSERT FALSE REPORT "Read interrupt a Write with Auto Precharge." SEVERITY NOTE;
                    END IF;
                END IF;

                -- Read Terminate Read after CL - 1
                IF (Data_out_enable = '1' AND ((Cas_latency_2 = '1' AND ((Burst_length_2 = '1' AND Burst_counter < 1) OR
                                                                         (Burst_length_4 = '1' AND Burst_counter < 3) OR
                                                                         (Burst_length_8 = '1' AND Burst_counter < 7))) OR
                                               (Cas_latency_3 = '1' AND ((Burst_length_4 = '1' AND Burst_counter < 2) OR
                                                                         (Burst_length_8 = '1' AND Burst_counter < 6))))) THEN
                    -- Interrupt a Read with Auto Precharge
                    IF Auto_precharge(CONV_INTEGER(RW_Interrupt_Bank)) = '1' AND Read_precharge(CONV_INTEGER(RW_Interrupt_Bank)) = '1' THEN
                        RW_interrupt_read(CONV_INTEGER(RW_Interrupt_Bank)) := '1';
                        ASSERT FALSE REPORT "Read interrupt a Read with Auto Precharge." SEVERITY NOTE;
                    END IF;
                END IF;

                -- Auto Precharge
                IF Addr(10) = '1' THEN
                    Auto_precharge (CONV_INTEGER(Ba)) := '1';
                    Count_precharge (CONV_INTEGER(Ba)) := 0;
                    RW_Interrupt_Bank := Ba;
                    Read_precharge (CONV_INTEGER(Ba)) := '1';
                END IF;
            END IF;

            -- Write Command
            IF Write_enable = '1' THEN
                -- Activate to Write
                ASSERT ((Ba="00" AND Act_b0='1') OR (Ba="01" AND Act_b1='1') OR
                        (Ba="10" AND Act_b2='1') OR (Ba="11" AND Act_b3='1'))
                    REPORT "Bank is not Activated for Write"
                    SEVERITY WARNING;

                -- Activate to Write
                ASSERT ((Ba = "00" AND NOW - RCD_chk0 >= tRCD) OR
                        (Ba = "01" AND NOW - RCD_chk1 >= tRCD) OR
                        (Ba = "10" AND NOW - RCD_chk2 >= tRCD) OR
                        (Ba = "11" AND NOW - RCD_chk3 >= tRCD))
                    REPORT "tRCD violation during Write"
                    SEVERITY WARNING;

                -- Latch write command, bank, column
                Command(0) := WRITE;
                Col_addr (0) := Addr(8 DOWNTO 0);
                Bank_addr (0) := Ba;

                -- Write Terminate Write Immediately
                IF Data_in_enable = '1' THEN
                    Data_in_enable := '0';
                    
                    -- Interrupt a Write with Auto Precharge
                    IF Auto_precharge(CONV_INTEGER(RW_Interrupt_Bank)) = '1' AND Write_precharge(CONV_INTEGER(RW_Interrupt_Bank)) = '1' THEN
                        RW_interrupt_write(CONV_INTEGER(RW_Interrupt_Bank)) := '1';
                        RW_interrupt_counter (CONV_INTEGER(RW_Interrupt_Bank)) := 0;
                        ASSERT FALSE REPORT "Write interrupt a Write with Auto Precharge." SEVERITY NOTE;
                    END IF;
                END IF;

                -- Write Terminate Read Immediately
                IF Data_out_enable = '1' THEN
                    Data_out_enable := '0';
                    
                    -- Interrupt a Read with Auto Precharge
                    IF Auto_precharge(CONV_INTEGER(RW_Interrupt_Bank)) = '1' AND Read_precharge(CONV_INTEGER(RW_Interrupt_Bank)) = '1' THEN
                        RW_interrupt_read(CONV_INTEGER(RW_Interrupt_Bank)) := '1';
                        ASSERT FALSE REPORT "Write interrupt a Read with Auto Precharge." SEVERITY NOTE;
                    END IF;
                END IF;

                -- Auto Precharge
                IF Addr(10) = '1' THEN
                    Auto_precharge (CONV_INTEGER(Ba)) := '1';
                    Count_precharge (CONV_INTEGER(Ba)) := 0;
                    RW_Interrupt_Bank := Ba;
                    Write_precharge (CONV_INTEGER(Ba)) := '1';
                END IF;
            END IF;

            -- Write with AutoPrecharge Calculation
            --      The device start internal precharge when:
            --          1.  Meet tRAS requirement
            --      and 2.  tWR cycle(s) after last valid data
            --       or 3.  Interrupt by a Read or Write (with or without Auto Precharge)
            --
            -- Note: Model is starting the internal precharge 1 cycle after they meet all the 
            --       requirement but tRP will be compensate for the time after the 1 cycle.
            IF ((Auto_precharge(0) = '1') AND (Write_precharge(0) = '1')) THEN
                IF (((NOW - RAS_chk0 >= tRAS) AND
                   (((Burst_length_1 = '1' OR Write_burst_mode = '1' ) AND Count_precharge(0) >= 1)  OR
                     (Burst_length_2 = '1'                             AND Count_precharge(0) >= 2)  OR
                     (Burst_length_4 = '1'                             AND Count_precharge(0) >= 4)  OR
                     (Burst_length_8 = '1'                             AND Count_precharge(0) >= 8))) OR
                     (RW_interrupt_write(0) = '1' AND RW_interrupt_counter(0) >= 1)) THEN
                    Auto_precharge(0) := '0';
                    Write_precharge(0) := '0';
                    RW_interrupt_write(0) := '0';
                    Pc_b0 := '1';
                    Act_b0 := '0';
                    RP_chk0 := NOW + tWRa;
                END IF;
            END IF;
            IF ((Auto_precharge(1) = '1') AND (Write_precharge(1) = '1')) THEN
                IF (((NOW - RAS_chk1 >= tRAS) AND
                   (((Burst_length_1 = '1' OR Write_burst_mode = '1' ) AND Count_precharge(1) >= 1)  OR
                     (Burst_length_2 = '1'                             AND Count_precharge(1) >= 2)  OR
                     (Burst_length_4 = '1'                             AND Count_precharge(1) >= 4)  OR
                     (Burst_length_8 = '1'                             AND Count_precharge(1) >= 8))) OR
                     (RW_interrupt_write(1) = '1' AND RW_interrupt_counter(1) >= 1)) THEN
                    Auto_precharge(1) := '0';
                    Write_precharge(1) := '0';
                    RW_interrupt_write(1) := '0';
                    Pc_b1 := '1';
                    Act_b1 := '0';
                    RP_chk1 := NOW + tWRa;
                END IF;
            END IF;
            IF ((Auto_precharge(2) = '1') AND (Write_precharge(2) = '1')) THEN
                IF (((NOW - RAS_chk2 >= tRAS) AND
                   (((Burst_length_1 = '1' OR Write_burst_mode = '1' ) AND Count_precharge(2) >= 1)  OR
                     (Burst_length_2 = '1'                             AND Count_precharge(2) >= 2)  OR
                     (Burst_length_4 = '1'                             AND Count_precharge(2) >= 4)  OR
                     (Burst_length_8 = '1'                             AND Count_precharge(2) >= 8))) OR
                     (RW_interrupt_write(2) = '1' AND RW_interrupt_counter(2) >= 1)) THEN
                    Auto_precharge(2) := '0';
                    Write_precharge(2) := '0';
                    RW_interrupt_write(2) := '0';
                    Pc_b2 := '1';
                    Act_b2 := '0';
                    RP_chk2 := NOW + tWRa;
                END IF;
            END IF;
            IF ((Auto_precharge(3) = '1') AND (Write_precharge(3) = '1')) THEN
                IF (((NOW - RAS_chk3 >= tRAS) AND
                   (((Burst_length_1 = '1' OR Write_burst_mode = '1' ) AND Count_precharge(3) >= 1)  OR
                     (Burst_length_2 = '1'                             AND Count_precharge(3) >= 2)  OR
                     (Burst_length_4 = '1'                             AND Count_precharge(3) >= 4)  OR
                     (Burst_length_8 = '1'                             AND Count_precharge(3) >= 8))) OR
                     (RW_interrupt_write(0) = '1' AND RW_interrupt_counter(3) >= 1)) THEN
                    Auto_precharge(3) := '0';
                    Write_precharge(3) := '0';
                    RW_interrupt_write(3) := '0';
                    Pc_b3 := '1';
                    Act_b3 := '0';
                    RP_chk3 := NOW + tWRa;
                END IF;
            END IF;

            -- Read with AutoPrecharge Calculation
            --      The device start internal precharge when:
            --          1.  Meet minimum tRAS requirement
            --      and 2.  CL - 1 cycle(s) before last valid data
            --       or 3.  Interrupt by a Read or Write (with or without Auto Precharge)
            IF ((Auto_precharge(0) = '1') AND (Read_precharge(0) = '1')) THEN
                IF (((NOW - RAS_chk0 >= tRAS) AND
                    ((Burst_length_1 = '1' AND Count_precharge(0) >= 1)  OR
                     (Burst_length_2 = '1' AND Count_precharge(0) >= 2)  OR
                     (Burst_length_4 = '1' AND Count_precharge(0) >= 4)  OR
                     (Burst_length_8 = '1' AND Count_precharge(0) >= 8))) OR
                     (RW_interrupt_read(0) = '1')) THEN
                    Pc_b0 := '1';
                    Act_b0 := '0';
                    RP_chk0 := NOW;
                    Auto_precharge(0) := '0';
                    Read_precharge(0) := '0';
                    RW_interrupt_read(0) := '0';
                END IF;
            END IF;
            IF ((Auto_precharge(1) = '1') AND (Read_precharge(1) = '1')) THEN
                IF (((NOW - RAS_chk1 >= tRAS) AND
                    ((Burst_length_1 = '1' AND Count_precharge(1) >= 1)  OR
                     (Burst_length_2 = '1' AND Count_precharge(1) >= 2)  OR
                     (Burst_length_4 = '1' AND Count_precharge(1) >= 4)  OR
                     (Burst_length_8 = '1' AND Count_precharge(1) >= 8))) OR
                     (RW_interrupt_read(1) = '1')) THEN
                    Pc_b1 := '1';
                    Act_b1 := '0';
                    RP_chk1 := NOW;
                    Auto_precharge(1) := '0';
                    Read_precharge(1) := '0';
                    RW_interrupt_read(1) := '0';
                END IF;
            END IF;
            IF ((Auto_precharge(2) = '1') AND (Read_precharge(2) = '1')) THEN
                IF (((NOW - RAS_chk2 >= tRAS) AND
                    ((Burst_length_1 = '1' AND Count_precharge(2) >= 1)  OR
                     (Burst_length_2 = '1' AND Count_precharge(2) >= 2)  OR
                     (Burst_length_4 = '1' AND Count_precharge(2) >= 4)  OR
                     (Burst_length_8 = '1' AND Count_precharge(2) >= 8))) OR
                     (RW_interrupt_read(2) = '1')) THEN
                    Pc_b2 := '1';
                    Act_b2 := '0';
                    RP_chk2 := NOW;
                    Auto_precharge(2) := '0';
                    Read_precharge(2) := '0';
                    RW_interrupt_read(2) := '0';
                END IF;
            END IF;
            IF ((Auto_precharge(3) = '1') AND (Read_precharge(3) = '1')) THEN
                IF (((NOW - RAS_chk3 >= tRAS) AND
                    ((Burst_length_1 = '1' AND Count_precharge(3) >= 1)  OR
                     (Burst_length_2 = '1' AND Count_precharge(3) >= 2)  OR
                     (Burst_length_4 = '1' AND Count_precharge(3) >= 4)  OR
                     (Burst_length_8 = '1' AND Count_precharge(3) >= 8))) OR
                     (RW_interrupt_read(3) = '1')) THEN
                    Pc_b3 := '1';
                    Act_b3 := '0';
                    RP_chk3 := NOW;
                    Auto_precharge(3) := '0';
                    Read_precharge(3) := '0';
                    RW_interrupt_read(3) := '0';
                END IF;
            END IF;
            
            -- Internal Precharge or Bst
            IF Command(0) = PRECH THEN                          -- PRECH terminate a read if same bank or all banks
                IF Bank_precharge(0) = Bank OR A10_precharge(0) = '1' THEN
                    IF Data_out_enable = '1' THEN
                        Data_out_enable := '0';
                    END IF;
                END IF;
            ELSIF Command(0) = BST THEN                         -- BST terminate a read regardless of bank
                IF Data_out_enable = '1' THEN
                    Data_out_enable := '0';
                END IF;
            END IF;

            IF Data_out_enable = '0' THEN
                Dq <= TRANSPORT (OTHERS => 'Z') AFTER tOH;
            END IF;

            -- Detect Read or Write Command
            IF Command(0) = READ THEN
                Bank := Bank_addr (0);
                Col := Col_addr (0);
                Col_brst := Col_addr (0);
                IF Bank_addr (0) = "00" THEN
                    Row := B0_row_addr;
                ELSIF Bank_addr (0) = "01" THEN
                    Row := B1_row_addr;
                ELSIF Bank_addr (0) = "10" THEN
                    Row := B2_row_addr;
                ELSE
                    Row := B3_row_addr;
                END IF;
                Burst_counter := 0;
                Data_in_enable := '0';
                Data_out_enable := '1';
            ELSIF Command(0) = WRITE THEN
                Bank := Bank_addr(0);
                Col := Col_addr(0);
                Col_brst := Col_addr(0);
                IF Bank_addr (0) = "00" THEN
                    Row := B0_row_addr;
                ELSIF Bank_addr (0) = "01" THEN
                    Row := B1_row_addr;
                ELSIF Bank_addr (0) = "10" THEN
                    Row := B2_row_addr;
                ELSE
                    Row := B3_row_addr;
                END IF;
                Burst_counter := 0;
                Data_in_enable := '1';
                Data_out_enable := '0';
            END IF;

            -- DQ (Driver / Receiver)
            Row_index := CONV_INTEGER (Row);
            Col_index := CONV_INTEGER (Col);

            IF Data_in_enable = '1' THEN
                IF Dqm(0) = '0' THEN
                    -- Initialize Memory
                    Init_mem_a (Bank, Row_index);

                    -- Write to Memory
                    CASE Bank IS
                        WHEN "00"   => Bank0_a (Row_index) (Col_index) := Dq(7 downto 0);
                        WHEN "01"   => Bank1_a (Row_index) (Col_index) := Dq(7 downto 0);
                        WHEN "10"   => Bank2_a (Row_index) (Col_index) := Dq(7 downto 0);
                        WHEN OTHERS => Bank3_a (Row_index) (Col_index) := Dq(7 downto 0);
                    END CASE;

                END IF;

                IF Dqm(1) = '0' THEN

                    Init_mem_b (Bank, Row_index);

                    -- Write to Memory
                    CASE Bank IS
                        WHEN "00"   => Bank0_b (Row_index) (Col_index) := Dq(15 downto 8);
                        WHEN "01"   => Bank1_b (Row_index) (Col_index) := Dq(15 downto 8);
                        WHEN "10"   => Bank2_b (Row_index) (Col_index) := Dq(15 downto 8);
                        WHEN OTHERS => Bank3_b (Row_index) (Col_index) := Dq(15 downto 8);
                    END CASE;
                END IF;

                -- Advance Burst Counter
                Burst_decode;

            ELSIF Data_out_enable = '1' THEN
                IF Dqm_reg0(0) = '0' or Dqm_reg0(1) = '0' THEN
                    -- Initialize Memory
                    Init_mem_a (Bank, Row_index);

                    -- Array Buffer
                    CASE Bank IS
                        WHEN "00"   => Dq_temp_a := Bank0_a (Row_index) (Col_index);
                        WHEN "01"   => Dq_temp_a := Bank1_a (Row_index) (Col_index);
                        WHEN "10"   => Dq_temp_a := Bank2_a (Row_index) (Col_index);
                        WHEN OTHERS => Dq_temp_a := Bank3_a (Row_index) (Col_index);
                    END CASE;

                    -- Initialize Memory
                    Init_mem_b (Bank, Row_index);

                    -- Array Buffer
                    CASE Bank IS
                        WHEN "00"   => Dq_temp_b := Bank0_b (Row_index) (Col_index);
                        WHEN "01"   => Dq_temp_b := Bank1_b (Row_index) (Col_index);
                        WHEN "10"   => Dq_temp_b := Bank2_b (Row_index) (Col_index);
                        WHEN OTHERS => Dq_temp_b := Bank3_b (Row_index) (Col_index);
                    END CASE;

                    -- Output
                    Dq(7 downto 0) <= TRANSPORT Dq_temp_a AFTER tAC;

                    -- Output
                    Dq(15 downto 8) <= TRANSPORT Dq_temp_b AFTER tAC;
                ELSE
                    Dq(7 downto 0) <= TRANSPORT (OTHERS => 'Z') AFTER tHZ;
                    Dq(15 downto 8) <= TRANSPORT (OTHERS => 'Z') AFTER tHZ;
                END IF;

                -- Advance Burst Counter
                Burst_decode;
            END IF;
        END IF;

    END PROCESS;    

    -- Clock timing checks
    Clock_check : PROCESS
        VARIABLE Clk_low, Clk_high : TIME := 0 ns;
    BEGIN       
        WAIT ON Clk;
        IF (Clk = '1' AND NOW >= 10 ns) THEN
            ASSERT (NOW - Clk_low >= tCL)
                REPORT "tCL violation"
                SEVERITY WARNING;
            ASSERT (NOW - Clk_high >= tCK)
                REPORT "tCK violation"
                SEVERITY WARNING;
            Clk_high := NOW;
        ELSIF (Clk = '0' AND NOW /= 0 ns) THEN
            ASSERT (NOW - Clk_high >= tCH)
                REPORT "tCH violation"
                SEVERITY WARNING;
            Clk_low := NOW;
        END IF;
    END PROCESS;

    -- Setup timing checks
    Setup_check : PROCESS
    BEGIN       
        WAIT ON Clk;
        IF Clk = '1' THEN
            ASSERT(Cke'LAST_EVENT >= tCKS)
                REPORT "CKE Setup time violation -- tCKS"
                SEVERITY WARNING;
            ASSERT(Cs_n'LAST_EVENT >= tCMS)
                REPORT "CS# Setup time violation -- tCMS"
                SEVERITY WARNING;
            ASSERT(Cas_n'LAST_EVENT >= tCMS)
                REPORT "CAS# Setup time violation -- tCMS"
                SEVERITY WARNING;
            ASSERT(Ras_n'LAST_EVENT >= tCMS)
                REPORT "RAS# Setup time violation -- tCMS"
                SEVERITY WARNING;
            ASSERT(We_n'LAST_EVENT >= tCMS)
                REPORT "WE# Setup time violation -- tCMS"
                SEVERITY WARNING;
            ASSERT(Dqm'LAST_EVENT >= tCMS)
                REPORT "Dqm Setup time violation -- tCMS"
                SEVERITY WARNING;
            ASSERT(Addr'LAST_EVENT >= tAS)
                REPORT "ADDR Setup time violation -- tAS"
                SEVERITY WARNING;
            ASSERT(Ba'LAST_EVENT >= tAS)
                REPORT "BA Setup time violation -- tAS"
                SEVERITY WARNING;
            ASSERT(Dq'LAST_EVENT >= tDS)
                REPORT "Dq Setup time violation -- tDS"
                SEVERITY WARNING;
        END IF;   
    END PROCESS;

    -- Hold timing checks
    Hold_check : PROCESS
    BEGIN
        WAIT ON Clk'DELAYED (tCKH), Clk'DELAYED (tCMH), Clk'DELAYED (tAH), Clk'DELAYED (tDH);
        IF Clk'DELAYED (tCKH) = '1' THEN
            ASSERT(Cke'LAST_EVENT > tCKH)
                REPORT "CKE Hold time violation -- tCKH"
                SEVERITY WARNING;
        END IF;
        IF Clk'DELAYED (tCMH) = '1' THEN
            ASSERT(Cs_n'LAST_EVENT > tCMH)
                REPORT "CS# Hold time violation -- tCMH"
                SEVERITY WARNING;
            ASSERT(Cas_n'LAST_EVENT > tCMH)
                REPORT "CAS# Hold time violation -- tCMH"
                SEVERITY WARNING;
            ASSERT(Ras_n'LAST_EVENT > tCMH)
                REPORT "RAS# Hold time violation -- tCMH"
                SEVERITY WARNING;
            ASSERT(We_n'LAST_EVENT > tCMH)
                REPORT "WE# Hold time violation -- tCMH"
                SEVERITY WARNING;
            ASSERT(Dqm'LAST_EVENT > tCMH)
                REPORT "Dqm Hold time violation -- tCMH"
                SEVERITY WARNING;
        END IF;
        IF Clk'DELAYED (tAH) = '1' THEN
            ASSERT(Addr'LAST_EVENT > tAH)
                REPORT "ADDR Hold time violation -- tAH"
                SEVERITY WARNING;
            ASSERT(Ba'LAST_EVENT > tAH)
                REPORT "BA Hold time violation -- tAH"
                SEVERITY WARNING;
        END IF;
        IF Clk'DELAYED (tDH) = '1' THEN
            ASSERT(Dq'LAST_EVENT > tDH)
                REPORT "Dq Hold time violation -- tDH"
                SEVERITY WARNING;
        END IF;
    END PROCESS;

END behave;
