sycomix/sumeru/tools/RPI/CC2541-programmer/debug.h

/*
Copyright (c) 2019 exotulip

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
THE SOFTWARE IS PROVIDED "AS IS", WITHOUT WARRANTY OF ANY KIND, EXPRESS OR
IMPLIED, INCLUDING BUT NOT LIMITED TO THE WARRANTIES OF MERCHANTABILITY,
FITNESS FOR A PARTICULAR PURPOSE AND NONINFRINGEMENT. IN NO EVENT SHALL THE
AUTHORS OR COPYRIGHT HOLDERS BE LIABLE FOR ANY CLAIM, DAMAGES OR OTHER
LIABILITY, WHETHER IN AN ACTION OF CONTRACT, TORT OR OTHERWISE, ARISING FROM,
OUT OF OR IN CONNECTION WITH THE SOFTWARE OR THE USE OR OTHER DEALINGS IN THE
SOFTWARE.
*/
//  Copyright (C) 2012 Texas Instruments Incorporated - http://www.ti.com/
//
//
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
//    Redistributions of source code must retain the above copyright
//    notice, this list of conditions and the following disclaimer.
//
//    Redistributions in binary form must reproduce the above copyright
//    notice, this list of conditions and the following disclaimer in the
//    documentation and/or other materials provided with the distribution.
//
//    Neither the name of Texas Instruments Incorporated nor the names of
//    its contributors may be used to endorse or promote products derived
//    from this software without specific prior written permission.
//
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
//#include "gpiolib.h"
#include <bcm2835.h>
#include <fcntl.h>
#include <unistd.h>
#include <stdio.h>

/******************************************************************************
* DEFINES
*/

// Start addresses on DUP (Increased buffer size improves performance)
#define ADDR_BUF0                   0x0000 // Buffer (512 bytes)
#define ADDR_DMA_DESC_0             0x0200 // DMA descriptors (8 bytes)
#define ADDR_DMA_DESC_1             (ADDR_DMA_DESC_0 + 8)

// DMA channels used on DUP
#define CH_DBG_TO_BUF0              0x01   // Channel 0
#define CH_BUF0_TO_FLASH            0x02   // Channel 1

// Debug commands
#define CMD_CHIP_ERASE              0x10
#define CMD_WR_CONFIG               0x19
#define CMD_RD_CONFIG               0x24
#define CMD_READ_STATUS             0x30
#define CMD_RESUME                  0x4C
#define CMD_DEBUG_INSTR_1B          (0x54|1)
#define CMD_DEBUG_INSTR_2B          (0x54|2)
#define CMD_DEBUG_INSTR_3B          (0x54|3)
#define CMD_BURST_WRITE             0x80
#define CMD_GET_CHIP_ID             0x68

// Debug status bitmasks
#define STATUS_CHIP_ERASE_BUSY_BM   0x80 // New debug interface
#define STATUS_PCON_IDLE_BM         0x40
#define STATUS_CPU_HALTED_BM        0x20
#define STATUS_PM_ACTIVE_BM         0x10
#define STATUS_HALT_STATUS_BM       0x08
#define STATUS_DEBUG_LOCKED_BM      0x04
#define STATUS_OSC_STABLE_BM        0x02
#define STATUS_STACK_OVERFLOW_BM    0x01

// DUP registers (XDATA space address)
#define DUP_DBGDATA                 0x6260  // Debug interface data buffer
#define DUP_FCTL                    0x6270  // Flash controller
#define DUP_FADDRL                  0x6271  // Flash controller addr
#define DUP_FADDRH                  0x6272  // Flash controller addr
#define DUP_FWDATA                  0x6273  // Clash controller data buffer
#define DUP_CLKCONSTA               0x709E  // Sys clock status
#define DUP_CLKCONCMD               0x70C6  // Sys clock configuration
#define DUP_MEMCTR                  0x70C7  // Flash bank xdata mapping
#define DUP_DMA1CFGL                0x70D2  // Low byte, DMA config ch. 1
#define DUP_DMA1CFGH                0x70D3  // Hi byte , DMA config ch. 1
#define DUP_DMA0CFGL                0x70D4  // Low byte, DMA config ch. 0
#define DUP_DMA0CFGH                0x70D5  // Low byte, DMA config ch. 0
#define DUP_DMAARM                  0x70D6  // DMA arming register

// Utility macros
//! Low nibble of 16bit variable
#define LOBYTE(w)           ((unsigned char)(w))
//! High nibble of 16bit variable
#define HIBYTE(w)           ((unsigned char)(((unsigned short)(w) >> 8) & 0xFF))


/******************************************************************************
* VARIABLES
*/
//! DUP DMA descriptor
const unsigned char dma_desc_0[8] =
{
    // Debug Interface -> Buffer
    HIBYTE(DUP_DBGDATA),            // src[15:8]
    LOBYTE(DUP_DBGDATA),            // src[7:0]
    HIBYTE(ADDR_BUF0),              // dest[15:8]
    LOBYTE(ADDR_BUF0),              // dest[7:0]
    0,                              // len[12:8] - filled in later
    0,                              // len[7:0]
    31,                             // trigger: DBG_BW
    0x11                            // increment destination
};
//! DUP DMA descriptor
const unsigned char dma_desc_1[8] =
{
    // Buffer -> Flash controller
    HIBYTE(ADDR_BUF0),              // src[15:8]
    LOBYTE(ADDR_BUF0),              // src[7:0]
    HIBYTE(DUP_FWDATA),             // dest[15:8]
    LOBYTE(DUP_FWDATA),             // dest[7:0]
    0,                              // len[12:8] - filled in later
    0,                              // len[7:0]
    18,                             // trigger: FLASH
    0x42,                           // increment source
};


/******************************************************************************
* FUNCTIONS
*/
/**************************************************************************//**
* @brief    Initializes the programmer by switching to 32 MHz XOSC and
*           configuring I/O.
*
* @param    data    Byte to write
*
* @return   None.
******************************************************************************/
void prog_delay(){
       unsigned long int t = 1000;
       for(int i = 0;i<t;++i);
}

#define MPIN_RESET_N	17
#define MPIN_DD		27
#define MPIN_DC		22
    
extern void bcm2835_gpio_fsel(uint8_t pin, uint8_t mode);

int programmer_init(int dd,int dc,int reset_n)
{
	if (!bcm2835_init()) {
		perror("bcm2835_init error\n");
		return(-1);
	}

	bcm2835_gpio_fsel(MPIN_DD, BCM2835_GPIO_FSEL_INPT);
	bcm2835_gpio_fsel(MPIN_DC, BCM2835_GPIO_FSEL_OUTP);
	bcm2835_gpio_fsel(MPIN_RESET_N, BCM2835_GPIO_FSEL_OUTP);
}

int programmer_close(){
	bcm2835_close();
}


/**************************************************************************//**
* @brief    Writes a byte on the debug interface. Requires DD to be
*           output when function is called.
*
* @param    data    Byte to write
*
* @return   None.
******************************************************************************/
#pragma inline
void write_debug_byte(unsigned char data)
{
    bcm2835_gpio_fsel(MPIN_DD, BCM2835_GPIO_FSEL_OUTP);
    unsigned char i;
    for (i = 0; i < 8; i++)
    {
        // Set clock high and put data on DD line
	bcm2835_gpio_set(MPIN_DC);
	prog_delay();
	(data & 0x80)?(bcm2835_gpio_set(MPIN_DD)):(bcm2835_gpio_clr(MPIN_DD));
	prog_delay();
        data <<= 1;
	bcm2835_gpio_clr(MPIN_DC);
	prog_delay();
	
    }
}


/**************************************************************************//**
* @brief    Reads a byte from the debug interface. Requires DD to be
*           input when function is called.
*
* @return   Returns the byte read.
******************************************************************************/
#pragma inline
unsigned char read_debug_byte(void)
{
    bcm2835_gpio_fsel(MPIN_DD, BCM2835_GPIO_FSEL_INPT);
    unsigned char i;
    unsigned char data;
    for (i = 0; i < 8; i++)
    {
	bcm2835_gpio_set(MPIN_DC);
	prog_delay();
        data <<= 1;
	data |= (char)bcm2835_gpio_lev(MPIN_DD);
	prog_delay();
	bcm2835_gpio_clr(MPIN_DC);
	prog_delay();

    }
    return data;
}


/**************************************************************************//**
* @brief    Function waits for DUP to indicate that it is ready. The DUP will
*           pulls DD line low when it is ready. Requires DD to be input when
*           function is called.
*
* @return   Returns 0 if function timed out waiting for DD line to go low
* @return   Returns 1 when DUP has indicated it is ready.
******************************************************************************/
#pragma inline
unsigned char wait_dup_ready(void)
{
    bcm2835_gpio_fsel(MPIN_DD, BCM2835_GPIO_FSEL_INPT);
    // DUP pulls DD low when ready
    unsigned char count = 0;
    while (bcm2835_gpio_lev(MPIN_DD) && count < 16)
    {
        // Clock out 8 bits before checking if DD is low again
        read_debug_byte();
        count++;
    }
    return (count == 16) ? 0 : 1;
}


/**************************************************************************//**
* @brief    Issues a command on the debug interface. Only commands that return
*           one output byte are supported.
*
* @param    cmd             Command byte
* @param    cmd_bytes       Pointer to the array of data bytes following the
*                           command byte [0-3]
* @param    num_cmd_bytes   The number of data bytes (input to DUP) [0-3]
*
* @return   Data returned by command
******************************************************************************/
unsigned char debug_command(unsigned char cmd, unsigned char *cmd_bytes,
                            unsigned short num_cmd_bytes)
{
    unsigned short i;
    unsigned char output = 0;

    // Send command
    write_debug_byte(cmd);

    // Send bytes
    for (i = 0; i < num_cmd_bytes; i++)
    {
        write_debug_byte(cmd_bytes[i]);
    }

    // Wait for data to be ready
    wait_dup_ready();

    // Read returned byte
    output = read_debug_byte();

    return output;
}


/**************************************************************************//**
* @brief    Resets the DUP into debug mode. Function assumes that
*           the programmer I/O has already been configured using e.g.
*           programmer_init().
*
* @return   None.
******************************************************************************/
void debug_init(void)
{
    	volatile unsigned char i;
    
	bcm2835_gpio_fsel(MPIN_DD, BCM2835_GPIO_FSEL_OUTP);
	bcm2835_gpio_clr(MPIN_DD);
	bcm2835_gpio_clr(MPIN_DC);
	bcm2835_gpio_clr(MPIN_RESET_N);
	prog_delay();
	bcm2835_gpio_set(MPIN_DC);
	prog_delay();
	bcm2835_gpio_clr(MPIN_DC);
	prog_delay();
	bcm2835_gpio_set(MPIN_DC);
	prog_delay();
	bcm2835_gpio_clr(MPIN_DC);
	prog_delay();
	bcm2835_gpio_set(MPIN_RESET_N);
	prog_delay();
}

unsigned char read_status(void)
{
    unsigned char id = 0;

    // Send command
    write_debug_byte(CMD_READ_STATUS);

    // Wait for data to be ready
    if(!wait_dup_ready())
        puts("not ready");

    // Read ID and revision
    id = read_debug_byte(); // ID

    return id;
}


unsigned char read_chip_id(void)
{
    unsigned char id = 0;

    // Send command
    write_debug_byte(CMD_GET_CHIP_ID);

    // Wait for data to be ready
    if(!wait_dup_ready())
	puts("not ready");

    // Read ID and revision
    id = read_debug_byte(); // ID
    read_debug_byte();      // Revision (discard)

    return id;
}


void burst_write_block(unsigned char *src, unsigned short num_bytes)
{
    unsigned short i;

    write_debug_byte(CMD_BURST_WRITE | HIBYTE(num_bytes));
    write_debug_byte(LOBYTE(num_bytes));
    for (i = 0; i < num_bytes; i++)
    {
        write_debug_byte(src[i]);
    }

    // Wait for DUP to be ready
    wait_dup_ready();

    read_debug_byte(); // ignore output

}


void chip_erase(void)
{
    volatile unsigned char status;
    // Send command
    debug_command(CMD_CHIP_ERASE, 0, 0);

    // Wait for status bit 7 to go low
    do {
        status = debug_command(CMD_READ_STATUS, 0, 0);
	//puts("CHIP ERASE BUSY");
    } while((status & STATUS_CHIP_ERASE_BUSY_BM));
}


void write_xdata_memory_block(unsigned short address,
                              const unsigned char *values,
                              unsigned short num_bytes)
{
    unsigned char instr[3];
    unsigned short i;

    // MOV DPTR, address
    instr[0] = 0x90;
    instr[1] = HIBYTE(address);
    instr[2] = LOBYTE(address);
    debug_command(CMD_DEBUG_INSTR_3B, instr, 3);

    for (i = 0; i < num_bytes; i++)
    {
        // MOV A, values[i]
        instr[0] = 0x74;
        instr[1] = values[i];
        debug_command(CMD_DEBUG_INSTR_2B, instr, 2);

        // MOV @DPTR, A
        instr[0] = 0xF0;
        debug_command(CMD_DEBUG_INSTR_1B, instr, 1);

        // INC DPTR
        instr[0] = 0xA3;
        debug_command(CMD_DEBUG_INSTR_1B, instr, 1);
    }
}


void write_xdata_memory(unsigned short address, unsigned char value)
{
    unsigned char instr[3];

    // MOV DPTR, address
    instr[0] = 0x90;
    instr[1] = HIBYTE(address);
    instr[2] = LOBYTE(address);
    debug_command(CMD_DEBUG_INSTR_3B, instr, 3);

    // MOV A, values[i]
    instr[0] = 0x74;
    instr[1] = value;
    debug_command(CMD_DEBUG_INSTR_2B, instr, 2);

    // MOV @DPTR, A
    instr[0] = 0xF0;
    debug_command(CMD_DEBUG_INSTR_1B, instr, 1);
}


unsigned char read_xdata_memory(unsigned short address)
{
    unsigned char instr[3];

    // MOV DPTR, address
    instr[0] = 0x90;
    instr[1] = HIBYTE(address);
    instr[2] = LOBYTE(address);
    debug_command(CMD_DEBUG_INSTR_3B, instr, 3);

    // MOVX A, @DPTR
    instr[0] = 0xE0;
    return debug_command(CMD_DEBUG_INSTR_1B, instr, 1);
}


void read_flash_memory_block(unsigned char bank,unsigned short flash_addr,
                             unsigned short num_bytes, unsigned char *values)
{
    unsigned char instr[3];
    unsigned short i;
    unsigned short xdata_addr = (0x8000 + flash_addr);

    // 1. Map flash memory bank to XDATA address 0x8000-0xFFFF
    write_xdata_memory(DUP_MEMCTR, bank);

    // 2. Move data pointer to XDATA address (MOV DPTR, xdata_addr)
    instr[0] = 0x90;
    instr[1] = HIBYTE(xdata_addr);
    instr[2] = LOBYTE(xdata_addr);
    debug_command(CMD_DEBUG_INSTR_3B, instr, 3);

    for (i = 0; i < num_bytes; i++)
    {
        // 3. Move value pointed to by DPTR to accumulator (MOVX A, @DPTR)
        instr[0] = 0xE0;
        values[i] = debug_command(CMD_DEBUG_INSTR_1B, instr, 1);

        // 4. Increment data pointer (INC DPTR)
        instr[0] = 0xA3;
        debug_command(CMD_DEBUG_INSTR_1B, instr, 1);
    }
}



void write_flash_memory_block(unsigned char *src, unsigned long start_addr,
                              unsigned short num_bytes)
{
    // 1. Write the 2 DMA descriptors to RAM
    write_xdata_memory_block(ADDR_DMA_DESC_0, dma_desc_0, 8);
    write_xdata_memory_block(ADDR_DMA_DESC_1, dma_desc_1, 8);

    // 2. Update LEN value in DUP's DMA descriptors
    unsigned char len[2] = {HIBYTE(num_bytes), LOBYTE(num_bytes)};
    write_xdata_memory_block((ADDR_DMA_DESC_0+4), len, 2);  // LEN, DBG => ram
    write_xdata_memory_block((ADDR_DMA_DESC_1+4), len, 2);  // LEN, ram => flash

    // 3. Set DMA controller pointer to the DMA descriptors
    write_xdata_memory(DUP_DMA0CFGH, HIBYTE(ADDR_DMA_DESC_0));
    write_xdata_memory(DUP_DMA0CFGL, LOBYTE(ADDR_DMA_DESC_0));
    write_xdata_memory(DUP_DMA1CFGH, HIBYTE(ADDR_DMA_DESC_1));
    write_xdata_memory(DUP_DMA1CFGL, LOBYTE(ADDR_DMA_DESC_1));

    // 4. Set Flash controller start address (wants 16MSb of 18 bit address)
    write_xdata_memory(DUP_FADDRH, HIBYTE( (start_addr>>2) ));
    write_xdata_memory(DUP_FADDRL, LOBYTE( (start_addr>>2) ));

    // 5. Arm DBG=>buffer DMA channel and start burst write
    write_xdata_memory(DUP_DMAARM, CH_DBG_TO_BUF0);
    burst_write_block(src, num_bytes);

    // 6. Start programming: buffer to flash
    write_xdata_memory(DUP_DMAARM, CH_BUF0_TO_FLASH);
    write_xdata_memory(DUP_FCTL, 0x06);

    // 7. Wait until flash controller is done
    while (read_xdata_memory(DUP_FCTL) & 0x80);
}
