sycomix/sumeru/sw/vhdl/timing_analysis_experiments/ram_propogation_test/ram_propogation_test.vhd

library ieee, lpm;
use ieee.std_logic_1164.ALL;
use ieee.numeric_std.ALL;
use lpm.lpm_components.lpm_ram_io;
use lpm.lpm_components.lpm_counter;

entity ram_propogation_test is
port(
        clk_50m:                in std_logic;
        btn:                    in std_logic;
        led:                    out std_logic;
        spi0_sck:               out std_logic;
        spi0_ss:                out std_logic;
        spi0_mosi:              out std_logic;
        spi0_miso:              in std_logic;
        sdram_data:             inout std_logic_vector(15 downto 0);
        sdram_addr:             out std_logic_vector(12 downto 0);
        sdram_ba:               out std_logic_vector(1 downto 0);
        sdram_dqm:              out std_logic_vector(1 downto 0);
        sdram_ras:              out std_logic;
        sdram_cas:              out std_logic;
        sdram_cke:              out std_logic;
        sdram_clk:              out std_logic;
        sdram_we:               out std_logic;
        sdram_cs:               out std_logic);
end entity;

architecture synth of ram_propogation_test is
        signal sys_clk:         std_logic;
        signal mem_clk:         std_logic;
        signal reset_n:         std_logic;
        signal reset:           std_logic;

        signal r_counter:       std_logic_vector(31 downto 0);

        signal r_ram_wren:      std_logic;
        signal r_ram_din:       std_logic_vector(31 downto 0);
        signal r_ram_dout:      std_logic_vector(31 downto 0);

begin
        spi0_sck <= '0';
        spi0_ss <= '0';
        spi0_mosi <= '0';
        sdram_addr <= (others => '0');
        sdram_data <= (others => 'Z');
        sdram_ba <= (others => '0');
        sdram_dqm <= (others => '0');
        sdram_ras <= '1';
        sdram_cas <= '1';
        sdram_cke <= '0';
        sdram_clk <= '0';
        sdram_we <= '1';
        sdram_cs <= '1';

        pll: entity work.pll 
                port map(
                        inclk0 => clk_50m,
                        c0 => sys_clk,
                        c1 => mem_clk,
                        locked => reset_n);

        reset <= not reset_n;
                        
        counter: lpm_counter
                generic map(
                        LPM_WIDTH => 32)
                port map(
                        clock => sys_clk,
                        q => r_counter,
                        aclr => reset);
        
        r_ram_din <= r_counter;
        r_ram_wren <= not r_counter(10);

        ram: entity work.alt_ram
                generic map(
                        AWIDTH => 10,
                        DWIDTH => 32)
                port map(
                        address => r_counter(9 downto 0),
                        clock => sys_clk,
                        data => r_ram_din,
                        wren => r_ram_wren,
                        q => r_ram_dout);
       
        process(sys_clk)
        begin
                if (rising_edge(sys_clk)) then
                        led <= r_ram_dout(26);
                end if;
        end process;
end architecture;
