sycomix/sumeru/(commit log)

2019-08-19 Add pcb designs (mark1, mark2) to repo
    [mark1.kicad_pcb, mark1.sch, mark1_fpga_config.sch, mark1_fpga_io.sch, mark1_power.sch, mark2.kicad_pcb, mark2.sch, mark2_fpga_config.sch]
2019-09-06 Sanitize / Prettify Pin definitions
2019-09-12 Re-sanitize pin assignments -- remove uart and gpio assignments for now.
2019-09-12 Add jtag_chain.cdf -- device programing file
2019-09-15 WIP: icache basic framework working at 150+Mhz Fmax
2019-09-21 SDRAM controller working revision, fix tRAS error. test bench is set to reproduce tRAS
    [sdram_controller.vhd, sdram_controller_test.vhd]
2019-09-21 Fixed SDRAM controller, good to go :-)
    [sdram_controller.vhd]
2019-09-23 Icache address bug fix
    [icache.vhd]
2019-09-24 Remove enable feature from memory arbitrator. Remove icache from cpu -- it was not working. SDRAM working revision -- with test code in cpu.vhd
    [cpu.vhd]
2019-09-24 ICache Bugfix work in progress -- Interim Commit - Rollback point
    [cpu.vhd, icache.vhd]
2019-09-26 Working 100 Mhz verions, icache is state based, next icache will be reverted to b1-b8 continuos strategy
    [cpu.vhd, icache.vhd, sdram_controller.vhd]
2019-09-26 Icache: Revert to state based strategy as it used less resources and had better timing
    [icache.vhd]
2019-10-13 DCache+TLB and ICache+TLB seem to be working correctly
    [cpu.vhd]
2019-10-14 NON-TLB & Paging version, Previous TLB Implementation was not working hence its been removed -- the implementations files still exists but CPU wiring has been removed
    [cpu.vhd]
2019-10-23 Re-enable TLB code w/ bugfixes from the TLB branch
    [cpu.vhd]
2019-11-22 Hardware Redesign : Mark 3
    [mark3.kicad_pcb, mark3.sch, mark3_fpga_config.sch, mark3_fpga_io.sch, mark3_power.sch]
2019-11-28 Revert to PRE TLB Cache Unification strategy. That did not work due to timing missed
    [cpu.vhd, icache.vhd]
2019-11-29 Integrate csr_controller and csr_cpu_gpio -- Led off/on seems to work
2019-12-01 Start redesign of cache
    [cpu.vhd, cpu_stage_idecode.vhd, icache.vhd]
2019-12-17 Remove debug pin
2019-12-17 CSR implemented along with csr_gpio.vhd - (led <= gpio(0))
2019-12-17 CPU_FETCH: Reintroduce once cycle delay for JAL Switch
2019-12-18 CSR GPIO: Bugfix & Set output on next rising sys_clk
    [csr_gpio.vhd]
2019-12-18 Remove skip_cycle and use br_taken (br_hit and br_result) instead
    [cpu_stage_iexec.vhd]
2019-12-23 iexec switch to clocking the input muxing for op_a op_b
2019-12-25 ERRATICALLY BUGGY VERSION: WIP
    [cpu_stage_iexec.vhd]
2019-12-26 WIP: Load byteena and correctly sized & signed output implemented
    [cpu_stage_idecode.vhd, cpu_stage_iexec.vhd]
2019-12-26 Bug fix: as required, make write_strob_r a toggle single
    [readwritecache_256x4x32.vhd]
2019-12-30 DIVIDE working: 4 stage pipeline - 5 cycle counter delay in iexec
2019-12-31 DIVEIDE Bugfix: Increase div_ctr to 6 (was 5)
    [cpu_stage_iexec.vhd]
2019-12-31 INTERRUPTS WIP
2020-01-01 INTERRUPTS RETURN: WIP
2020-01-01 BUGFIX: Interrupt Handling in idecode
    [cpu_stage_idecode.vhd]
2020-01-01 **RADICAL changes to ifetch and idecode to facilitate raising of interrupts. c6ab235fc192d14625a0c713357f9949c8f2c8c9 is a know good state before these changes
2020-01-02 INTR RET code is buggy debugging in progress
    [csr_counters.vhd]
2020-01-03 RADICAL Change: New decode implementation - works only with hardcoded switch as yet ... same as last impl -- debugging in progress
2020-01-03 GOOD VERSION: INTR RETURN WORKING. Bug: Don't set cxfer on OP_TYPE_B in decode. Bug: Output complete address from interrupt handler instead of a partial vector; Partial vector with concatenation does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
    [boot.c, cpu_stage_idecode.vhd, cpu_types.vhd, intr_controller.vhd]
2020-01-04 Revert last changes to CSR numbering
    [sumeru_constants.vhd]
2020-01-04 Buggy Version. Seem like previous fix to intr_handler to emit full address still does not work. This version shows different behaviour for simulation and actual. Seems like immediate is not getting c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
    [boot.c]
2020-01-04 BUG: CSR modules were relying on old sel signal instead of just op_valid and reg. causing wrong writes
    [csr_counters.vhd, csr_gpio.vhd, csr_timer.vhd]
2020-01-04 IRET (aka. switch) seems to be working -- more testing needed
2020-01-05 INTR and SWITCH REMOVAL WIP
2020-01-05 CRITICAL Bugfix in IEXEC. zero register was being read as having nonzero values (fix: wren_nz vs wren)
    [cpu_stage_iexec.vhd]
2020-01-05 SHIFT BUGFIX - srai sign bit fix
    [cpu_shift.vhd]
2020-01-05 Bug fix: mulh was being decoded as shift -- mulh working
    [cpu_stage_idecode.vhd, cpu_types.vhd]
2020-01-05 DIV(U) and REM(U) working with minimal latency (emphirically checked @85MHZ) of pipeline 8 and counter 9 -- counter 8 does not work nor does pipeline 6
    [cpu_stage_iexec.vhd]
2020-01-05 BUGFIX ICACHE FLUSH, meta_wren was not set
    [readcache_256x4x32.vhd]
2020-01-06 REWORK : CPU_V2 : RV32IMU - riscv-test PASS : Re-integrated back into master sumeru/cpu : with history commits from REWORK branch
    [boot.c, cpu.vhd, cpu_alu.vhd, cpu_muldiv.vhd, cpu_shift.vhd]
2020-01-06 REWORK : CPU_V2 : RV32IMU WITH Interrupt Handling. Re-integrated back from REWORK without history. REWORK started on commit: 5fec5ab54df6f6b5f4219dd3bd3cd47f69e9829d
    [bootcode-INTR-BLINK-boot.c, cpu.vhd, cpu_stage_idecode.vhd, cpu_stage_iexec.vhd, cpu_types.vhd, csr_counters.vhd, csr_timer.vhd, intr_controller.vhd]
2020-01-08 Add SPI Flash Datasheet
2020-01-08 Import RPI spi-flash programs (scheme)
2020-01-08 Reset (aclr) cycle/inst counters on boot
    [cpu.vhd, csr_counters.vhd]
2020-01-09 UART WIP
2020-01-09 UART Transmit working at 115200
2020-01-09 asm_handle_interrupt and handle_interrupt -- register saving interrupt handling code -- caveat we save/restore 15 registers (60 bytes) -- need a better strategy
2020-01-10 uart: cosmetic changes
2020-01-10 UART code structuring : UART RX WIP
2020-01-10 UART RECV WIP
2020-01-10 UART RX Impl done
2020-01-10 UART RECV working -- decent performance -- few errors at full speed back to back echo recv->txmit
    [csr_uart_rs232.vhd]
2020-01-11 csr_uart: Change code structure to avoid asynchonously incrementing tx_buf_curpos -- seems likes this could cause curpos to become greater than lenght and trigger a continuous transfer
    [csr_uart_rs232.vhd]
2020-01-13 csr_timer ack interrupts and set counter on *all* writes
2020-01-13 boot.c: timer+shiftblink code
2020-01-16 BUGGY Version: UART TX get's stuck in a loop
    [boot.c]
2020-01-20 RV32IMU with TIMER and UART -- Interrupts are working correctly with this revision -- CLOCK = 80MHz
    [boot.c, cpu.vhd, cpu_stage_iexec.vhd, cpu_types.vhd, csr_timer.vhd, csr_uart_rs232.vhd, intr_controller.vhd]
2020-01-23 BOOTLOADER WIP: change uart rx and tx buffer location to 0x2000 and 0x2100
2020-01-23 KERNEL WORKING with Quartus 19.1 [timing/wierd store-word error with 14.1]
    [boot.c]
2020-01-23 csr_uart bugfix set csr_sel_result to be inout instead of just out
    [csr_uart_rs232.vhd]
2020-01-25 Blinky add missing boot.c
    [boot.c]
2020-01-26 Add timer_intr_enabled semantics to csr_timer
2020-01-27 Revert timer intr_enabled changed ... It makes the routing unstable.
    [csr_timer.vhd]
2020-01-27 Remove old tools: genloadableimage, uartcodedump and uartcodeloader
2020-01-27 commit missing bluetooth_bootloader support files
    [main.c, util.h]
2020-01-27 **SCRATCH LIBC KERNEL Printf working
2020-01-29 Bugfix uart_rx to flush rx_buffer correctly, Report waiting status by blinking led when when waiting in blocking rx and tx
    [boot.c]
2020-01-29 Kernel Scratch working iwth uart0_blocking write -- todo next printf
2020-01-30 Scratch+ Printf Working with Quartus 14.0
2020-01-30 Set Quartus Optimization Mode to AGGRESSIVE PERFORMANCE, without it kernels/scratch does not printf ??, HK what is going on :
2020-02-03 Add intergers parameters to scratch.c printf code
2020-02-03 Dhrystone : simply code, customize printfs -- last DMIPS may be double of actual this version shows varying performance based on code layout
2020-02-03 **BUG : Fix flushing of buffers in boot.c. ***Move to 16 byte bootclient protocol
    [boot.c]
2020-02-03 Dhrystone small benchmarks, fits in Icache, prints binary results via uart0 - **Achives 29.07 DMIPS - Takes 75300013 cycles at 75MHz for 50000 Dhrystone 2.2 Iterations -- hitherto relies on optimized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
2020-02-04 Move common uart0 code to sys-libs/driers
2020-02-04 Symlink uart0 driver in cpu/BOOT
2020-02-04 UART Code reorganization WIP
2020-02-04 blinky: Adjust makefile for common uart code
2020-02-04 UART common code factorisation WIP
2020-02-04 Introduce uart_io.[ch] in libc
2020-02-05 Add support for MEM_METHOD malloc to coremark, switch benchmark to use MALLOC by default
2020-02-12 UART -- Add support for configurable BAUD rates
2020-02-12 New UART startegy -- Double buffer WIP
2020-02-12 Make cpu/BOOTCODE uart functions independent as we move kernels to use a new uart strategy (2buf)
2020-02-13 UART: Do not reset curpos when BIT(31) of CTRL register is set -- required to facilitate of reading rx/tx ctrl registers during rx/tx operation
    [csr_uart_rs232.vhd]
2020-02-14 BUGGY Version -- see sys-libs/drivers/interrupt.c -- seems like activating a strategically located NOP in handle_interrupt causes uart_tx to hang??
    [interrupts.c, uart0.c, uart0.h]
2020-02-16 WIP -- non functional commit, i.e. bug still reproduces -- comment out lines in handle_interrupt
    [interrupts.c]
2020-02-16 ***BUG FILE: icache readcache was not invalidating cache lines correctly on flush - fixed
    [readcache_256x4x32.vhd]
2020-02-16 BOOTCODE: set led to known state (on) on Jmp to loaded code
2020-02-16 cpu_tb: add commented uart_rx code
2020-02-17 **BUGFIX : CPU STAGE IEXEC, STORE DATA WAS NOT BEING SET CORRECTLY, CAUSE WRONG DATA TO BE WRITTEN ON STORES -- FIXED
    [cpu_stage_iexec.vhd]
2020-02-17 csr.h remove extra init code from uart0_get_tx/rx
2020-02-18 uart0.h WIP
2020-02-18 ***BUG FIX: csr_uart in rx section, when idle and reset_curpos is set reset rx_buf_curpos otherwise gpio_get_rx will keep returning the last value istead of 0
    [csr_uart_rs232.vhd]
2020-02-18 driver/interrupts.c: WIP
2020-02-18 tools/RPI: Commit RPI tools
    [pins.cfg]
2020-02-18 BUG FIX entry.S -- asm_handle_interrupt was setting sp to 0x2000 instead of servicing interrupts on the user stack
2020-02-19 Add Coremark results to README. Make bluetooth addr and write-handle configurable via sw/conf/bluetooth.cfg. Modify coremark/Makefile to use bluetooth.cfg
    [bluetooth.cfg]
2020-02-20 bluetooth: cfg change
    [bluetooth.cfg]
2020-02-21 ** NEW UART code - Both TX and RX are streambuf based
2020-02-22 NEW UART code WIP
2020-02-23 **BUGGY Version newk freezes in memcpy but a nop mitigates the condition -- FIND BUG
    [interrupts.c, newk.c, uart0.c, uart0.h]
2020-02-23 Blink working : repeatedly send on char amidst timer interrups every 0x10000 ticks
2020-02-23 NEWK STREAMBUF Code working with uart_blocking_read/write echo length = 1
2020-02-23 COREMARK: Call uart0_start_engine in core_portme.c
2020-02-23 NEWK STREAMBUF Code call uart0_start_engine : Dhrystone Bmark_median
2020-02-24 Add drivers: consprod.[ch]
2020-02-26 Fix SDRAM simulation code to respect both Dqm(0) *AND* Dqm(1) during writes
    [sim_sdram_mt48lc16m16a2.vhd]
2020-03-02 sumeru constants: add commented settings for 72MHz UART counters
2020-03-05 ***BUGFIX: There was a subtle bug that changed timing based on the number of signals interfacing with the component cpu_stage_iexec. This commit makes the ivector_addr, ctx_pc_save and ctx_pc_switch 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
    [cpu.vhd, cpu_stage_iexec.vhd]
2020-03-11 Add ILI9488 (320x480) LCD Driver datasheet
